upbeattechtw/Trina_Pi_UP201_MCU_Board/hardware/BOM/UP201 MCU BOARD 2V0 BOM.xlsx

UP201 MCU Board Revised: Tuesday, April 01, 2025
00_Placement Revision: 2.0
Bill Of Materials April 1,2025 16:55:33
Item | Component | Quantity | Reference | PCB Footprint | Description | Supplier [part#] | Manufacturer [part#] | comment
1 | 0.1uF, 25V, 20% | 53 | CB1,CB2,CB3,CB4,CB5,CB6,CB7,CB8,CB9,CB10,CB11,CB12,CB13,CB14,CB15,CB16,CB17,CB18,CB19,CB20,CB21,CB23,CB24,CB25,CB26,CB27,CB28,CB29,CB30,CB31,CB32,CB33,CB34,CB35,CB36,CB37,CB38,CB39,CB40,CB41,CB42,CB43,C46,C48,C50,C52,C54,C38,C39,C40,C41,C43,C55 | SMD0402 | CAP CER 0.1uF,25V,20%,SMD0402 | DigiKey | Yageo
2 | 0.01uF, 25V, 20% | 1 | CB22 | SMD0402 | CAP CER 0.01uF,25V,20%,SMD0402 | DigiKey | Yageo
3 | 2.2uF, 16V, 20% | 3 | C8,C14,CB44 | SMD0603 | CAP CER 2.2uF,16V,20%,SMD0603 | DigiKey | Yageo
4 | Connector_MCU_Board | 1 | CON1 | DIP40_51x21mm_2.54 | NC/Connector_MCU_Board | DigiKey |  | NC
5 | USBC 24P MIDDLE MOUNT | 1 | CON2 | USBC_24P_0_5P | USBC 24P MIDDLE MOUNT | DigiKey | Molex [2171840001]
6 | 10uF, 16V, 20% | 26 | CT1,C1,CT2,C2,CT3,C5,C6,C7,C9,C13,C15,C16,C17,C18,C19,C20,C22,C28,C31,C32,C45,C47,C49,C51,C53,C10 | SMD0603 | CAP CER 10uF,16V,20%,SMD0603 | DigiKey | Yageo
7 | 16pF, 50V, 20% | 2 | C3,C4 | SMD0402 | CAP CER 16pF,50V,20%,SMD0402 | DigiKey | Yageo
8 | 22uF, 10V, 20% | 2 | C11,C12 | SMD0603 | CAP CER 22uF,10V,20%,SMD0603 | DigiKey | Yageo
9 | 1uF, 16V, 20% | 3 | C21,C23,C26 | SMD0603 | CAP CER 1uF,16V,20%,SMD0603 | DigiKey | Yageo
10 | 1nF, 50V, 20% | 1 | C24 | SMD0402 | CAP CER 1nF,50V,20%,SMD0402 | DigiKey | Yageo
11 | 4.7uF, 16V, 20% | 2 | C25,C29 | SMD0603 | CAP CER 4.7uF,16V,20%,SMD0603 | DigiKey | Yageo
12 | 2.2uF, 25V, 10% | 1 | C27 | SMD0402 | CAP CER 2.2uF,25V,10%,SMD0402 | DigiKey | Yageo
13 | 220nF, 10V, 20% | 1 | C30 | SMD0402 | CAP CER 220nF,10V,20%,SMD0402 | DigiKey | Yageo
14 | 20pF, 50V, 10% | 2 | C33,C34 | SMD0402 | CAP CER 20pF,50V,10%,SMD0402 | DigiKey | Yageo
15 | 3.3uF, 16V, 20% | 1 | C35 | SMD0603 | CAP CER 3.3uF,16V,20%,SMD0603 | DigiKey | Yageo | 4.7uF substitute
16 | 330pF, 50V, 5% | 2 | C36,C37 | SMD0402 | CAP CER 330pF,50V,5%,SMD0402 | DigiKey | Yageo
18 | 1uF, 25V, 20% | 1 | C42 | SMD0603 | CAP CER 1uF,25V,20%,SMD0603 | DigiKey | Yageo
19 | 33nF, 16V, 20% | 1 | C44 | SMD0402 | CAP CER 33nF,16V,20%,SMD0402 | DigiKey | Yageo
20 | 22uF, 16V, 20% | 4 | C56,C57,C58,C59 | SMD0603 | CAP CER 22uF,16V,20%,SMD0603 | DigiKey | Yageo | 10uF substitute
21 | 47uF, 6.3V, 20% | 1 | C60 | SMD0603 | CAP CER 47uF,6.3V,20%,SMD0603 | DigiKey | Yageo | 22uF substitute
22 | Diode Zener 24V 150V clamp | 4 | D1,D2,D3,D4 | ESD_0603 | Diode Zener, Transient voltage suppressor 150V | Mouser | Littelfuse [PGB1010603]
23 | Diode Schottky 30V 5A | 1 | D5 | SOD128 | Diode Schottky,30V,5A,SOD128 | Mouser | Nexperia USA [PMEG3050BEP]
24 | 30Ω, 100MHz, 400mA | 5 | FB1,FB2,FB3,FB4,FB5 | SMD0603 | FERRITE BEAD 30Ω@100MHz,5A,SMD0603 | DigiKey | TDK [MPZ1608S300]
25 | LED RED | 2 | LED1,LED3 | SMD0603 | LED RED color | DigiKey | XINGLIGHT
26 | LED ORANGE | 1 | LED2 | SMD0603 | LED ORANGE color | DigiKey | XINGLIGHT
27 | 2.2uH, 2.19A, 59mΩ | 3 | L1,L2,L3 | SMD_4.5x3.9 | Inductor 2.2uH, 2.19A, 59mΩ | Mouser | TDK [VLCF4020T_2R2N]
28 | 1uH, shielded, 2.7A, 57mΩ | 1 | L4 | Metric2016 | Inductor 1uH, 2.7A, 57mΩ | Mouser | Murata [DFE201610E_1R0M=p2]
29 | Push Button Switch | 2 | PB1,PB2 | SW_SMD_2P_3x2.5 | Switch PushButton,Blue color,SMD_2P | DigiKey | Omron [B3U-1000P]
30 | 1KΩ, 1% | 7 | R1,R74,R75,R76,R82,R83,R88 | SMD0402 | RES 1KΩ,1/16W,1%,SMD0402 | DigiKey | Yageo | NC
31 | 4.7MΩ,1/16W,1% | 1 | R3 | SMD0402 | RES 4.7MΩ,1/16W,1%,SMD0402 | DigiKey | Yageo
32 | 10Ω,1% | 2 | R4,R21 | SMD0402 | RES 10Ω,1/16W,1%,SMD0402 | DigiKey | Yageo
33 | 1Ω,5% | 1 | R5 | SMD0402 | RES 1Ω,1/16W,5%,SMD0402 | DigiKey | Yageo
34 | 0Ω, 5% | 7 | R6,R7,R9,R10,R11,R17,R79 | SMD0402 | RES 0Ω,1/16W,5%,SMD0402 | DigiKey | Yageo
35 | 100KΩ, 1% | 10 | R8,R23,R26,R30,R31,R46,R47,R48,R49,R62 | SMD0402 | RES 100KΩ,1/16W,1%,SMD0402 | DigiKey | Yageo
36 | 0Ω, 100mW, 1% | 9 | R12,R13,R14,R16,R19,R20,R36,R52,R54 | SMD0603 | RES 0Ω,100mW,1%,SMD0603 | DigiKey | Yageo
37 | 51KΩ, 1% | 1 | R15 | SMD0402 | RES 51KΩ,1/16W,1%,SMD0402 | DigiKey | Yageo | NC
38 | 10KΩ, 1% | 16 | R22,R39,R41,R44,R45,R56,R58,R59,R66,R67,R68,R77,R78,R80,R81,R85 | SMD0402 | RES 10KΩ,1/16W,1%,SMD0402 | DigiKey | Yageo
39 | 1KΩ, 1% | 8 | R24,R27,R70,R71,R72,R73,R84,R87 | SMD0402 | RES 1KΩ,1/16W,1%,SMD0402 | DigiKey | Yageo
40 | 0Ω, 100mW, 1% | 2 | R25,R37 | SMD0603 | RES 0Ω,100mW,1%,SMD0603 | DigiKey | Yageo | NC
41 | 150KΩ,1% | 1 | R28 | SMD0402 | RES 150KΩ,1/16W,1%,SMD0402 | DigiKey | Yageo | NC
42 | 1.3KΩ,1% | 1 | R29 | SMD0402 | RES 1.3KΩ,1/16W,1%,SMD0402 | DigiKey | Yageo
43 | 4.7KΩ,1% | 5 | R32,R33,R34,R35,R53 | SMD0402 | RES 4.7KΩ,1/16W,1%,SMD0402 | DigiKey | Yageo
44 | 10KΩ,1% | 2 | R38,R42 | SMD0402 | RES 10KΩ,1/16W,1%,SMD0402 | DigiKey | Yageo | NC
45 | 22Ω,1% | 2 | R50,R86 | SMD0402 | RES 22Ω,1/16W,1%,SMD0402 | DigiKey | Yageo
46 | 22Ω,1% | 2 | R51,R55 | SMD0402 | RES 22Ω,1/16W,1%,SMD0402 | DigiKey | Yageo | NC
47 | 4.3KΩ,1% | 1 | R57 | SMD0402 | RES 4.3KΩ,1/16W,1%,SMD0402 | DigiKey | Yageo
48 | 12KΩ,1% | 1 | R60 | SMD0402 | RES 12KΩ,1/16W,1%,SMD0402 | DigiKey | Yageo
49 | 220Ω,1% | 1 | R61 | SMD0402 | RES 220Ω,1/16W,1%,SMD0402 | DigiKey | Yageo
50 | 20KΩ,1% | 1 | R63 | SMD0402 | RES 20KΩ,1/16W,1%,SMD0402 | DigiKey | Yageo
51 | 470Ω,1% | 1 | R64 | SMD0402 | RES 470Ω,1/16W,1%,SMD0402 | DigiKey | Yageo
52 | 15KΩ,1% | 1 | R65 | SMD0402 | RES 15KΩ,1/16W,1%,SMD0402 | DigiKey | Yageo
53 | 2.2KΩ,1% | 1 | R69 | SMD0402 | RES 2.2KΩ,1/16W,1%,SMD0402 | DigiKey | Yageo
54 | Circuit Break1 | 1 | SB1 | SJO_S | NC/Circuit Break1 |  |  | NC
55 | TestPoint,DIP_2.54 | 14 | TP3,TP4,TP5,TP6,TP7,TP8,TP9,TP10,TP11,TP12,TP13,TP14,TP15,TP16 | SIP_1P | NC/TP_2.54 |  |  | NC
56 | UP201 | 1 | U1 | WLCSP64_3x3_0.35 | IC UP201, Ultra low power SOC | Mouser (in progress) | Upbeat Tech
57 | MX25U1632 | 1 | U2 | USON8_2x3_0.5 | IC MX25U1632FZU, NOR Flash,16Mb | DigiKey | Macronix | MX25U16356 upper limit
58 | BQ21040DBVR | 1 | U3 | SOT23-6 | IC BQ21040DBVR, power management, charger | DigiKey | Texas Instrument | NC
59 | TPS65023 | 1 | U4 | WQFN40_5x5_0.4 | IC TPS65023, power management with i2c | DigiKey | Texas Instrument
60 | TPS628604 | 1 | U5 | DSBGA8_1.3x0.6_0.35 | IC TPS628604, Regulator, 600mA output | DigiKey | Texas Instrument
61 | SN74LVC2G14DBVR | 1 | U6 | SOT23-6 | IC SN74LVC1G14DBVR_SOT23, Dual Schmitt trigger | Mouser | Texas Instrument
62 | FT2232HP | 1 | U8 | QFN68_8x8_0.4 | IC FT2232HP, USB bridge Type-C 3.0 | Mouser | FTDI
63 | CommonModeChoke 23nH 500mA | 1 | U9 | 0805_4p | Common Mode Choke, 23nH @ 100MHz, 500mA | DigiKey | Coilcraft
64 | 93LC66BT_I/OT | 1 | U10 | SOT23-6 | IC 93LC66BT_I/OT, EEPROM 256x16 | Mouser | Microchip
65 | TXS0104ERUT | 2 | U11,U12 | UQFN12_1.7x2_0.4 | IC TXS0104ERUT, Bi-dir level shifter | Mouser | Texas Instrument
66 | SN74LVC1G08DBVR | 1 | U13 | SOT23-5 | IC SN74LVC1G08DBVR_SOT23, AND gate | Mouser | Texas Instrument
67 | TPS22917 | 1 | U14 | SOT23-6 | IC TPS22917, P-ch Power Switch, 5.5V,2A | Mouser | Texas Instrument | NC
68 | TPS22917 | 1 | U15 | SOT23-6 | IC TPS22917, P-ch Power Switch, 5.5V,2A | Mouser | Texas Instrument | NC
69 | TPS22917 | 1 | U16 | SOT23-6 | IC TPS22917, P-ch Power Switch, 5.5V,2A | Mouser | Texas Instrument
70 | Crystal_32.768KHz_12.5p_70K | 1 | Y1 | Crystal_3.2x1.5_SMD | Crystal 32.768KHz,20ppm,12.5p_70KΩ_SMD | Mouser | ECS [ECS-.327-12.5-34B]
71 | Crystal_12MHz,50PPM | 1 | Y2 | XTAL_4P_2.5X2 | Crystal 12MHz,50ppm,2_0.5x2mm | DigiKey [XC2722] | ECS [ECS-120-10-36Q]
