upbeattechtw/Trina_Pi_UP201_MCU_Board/hardware/BOM/UP201 MCU BOARD 2V0 position.xlsx

PartType | RefDes | PartDecal | Pins | Layer | Orient. | X | Y | SMD | Glued
C0603 | C1 | C0603 | 2 | Bottom | 90 | 997.736 | 913.287 | Yes | No
C0603 | C2 | C0603 | 2 | Top | 0 | 1003.986 | 775.787 | Yes | No
C0402 | C3 | C0402 | 2 | Top | 90 | 931.25 | 1187.5 | Yes | No
C0402 | C4 | C0402 | 2 | Top | 90 | 993.75 | 1187.5 | Yes | No
C0603 | C5 | C0603 | 2 | Top | 270 | 878.986 | 69.537 | Yes | No
C0603 | C6 | C0603 | 2 | Top | 0 | 810.236 | 625.787 | Yes | No
C0603 | C7 | C0603 | 2 | Top | 180 | 853.986 | 557.037 | Yes | No
C0603 | C8 | C0603 | 2 | Bottom | 90 | 547.736 | 538.287 | Yes | No
C0603 | C9 | C0603 | 2 | Top | 180 | 566.486 | 563.287 | Yes | No
C0603 | C10 | C0603 | 2 | Top | 270 | 941.486 | 69.537 | Yes | No
C0603 | C11 | C0603 | 2 | Top | 180 | 466.486 | 50.787 | Yes | No
C0603 | C12 | C0603 | 2 | Top | 180 | 966.486 | 619.537 | Yes | No
C0603 | C13 | C0603 | 2 | Top | 180 | 641.486 | 769.537 | Yes | No
C0603 | C14 | C0603 | 2 | Bottom | 0 | 460.236 | 507.037 | Yes | No
C0603 | C15 | C0603 | 2 | Bottom | 180 | 460.236 | 563.287 | Yes | No
C0603 | C16 | C0603 | 2 | Top | 0 | 572.736 | 688.287 | Yes | No
C0603 | C17 | C0603 | 2 | Bottom | 0 | 647.736 | 157.037 | Yes | No
C0603 | C18 | C0603 | 2 | Bottom | 180 | 778.986 | 307.037 | Yes | No
C0603 | C19 | C0603 | 2 | Bottom | 90 | 647.736 | 269.537 | Yes | No
C0603 | C20 | C0603 | 2 | Bottom | 90 | 810.236 | 400.787 | Yes | No
C0603 | C21 | C0603 | 2 | Bottom | 180 | 266.486 | 1119.537 | Yes | No
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
SJO_S | SB1 | SJO_S | 2 | Top | 180 | 500 | 985 | Yes | No
SIP_1P | TP3 | SIP_1P | 1 | Top | 90 | 272.736 | 63.287 | Yes | No
SIP_1P | TP4 | SIP_1P | 1 | Top | 90 | 360.236 | 63.287 | Yes | No
SIP_1P | TP5 | SIP_1P | 1 | Top | 0 | 1128.986 | 2319.537 | Yes | No
SIP_1P | TP6 | SIP_1P | 1 | Bottom | 0 | 178.986 | 57.037 | Yes | No
SIP_1P | TP7 | SIP_1P | 1 | Top | 0 | 1153.986 | 69.537 | Yes | No
SIP_1P | TP8 | SIP_1P | 1 | Bottom | 0 | 1153.986 | 69.537 | Yes | No
SIP_1P | TP9 | SIP_1P | 1 | Bottom | 0 | 353.986 | 1919.537 | Yes | No
SIP_1P | TP10 | SIP_1P | 1 | Top | 0 | 853.986 | 1869.537 | Yes | No
SIP_1P | TP11 | SIP_1P | 1 | Bottom | 0 | 1128.986 | 2319.537 | Yes | No
SIP_1P | TP12 | SIP_1P | 1 | Top | 0 | 178.986 | 57.037 | Yes | No
SIP_1P | TP13 | SIP_1P | 1 | Top | 0 | 197.736 | 675.787 | Yes | No
SIP_1P | TP14 | SIP_1P | 1 | Top | 0 | 278.986 | 675.787 | Yes | No
SIP_1P | TP15 | SIP_1P | 1 | Top | 0 | 366.486 | 675.787 | Yes | No
SIP_1P | TP16 | SIP_1P | 1 | Top | 90 | 460.236 | 675.787 | Yes | No
WLCSP64_3X3_0.35 | U1 | WLCSP64_3X3_0.35 | 64 | Top | 270 | 828.986 | 844.537 | Yes | No
USON8_2X3_0.5 | U2 | USON8_2X3_0.5 | 9 | Top | 0 | 706.486 | 1145.787 | Yes | No
SOT23-6 | U3 | SOT23-6 | 6 | Top | 0 | 341.486 | 1113.287 | Yes | No
WQFN40_5X5_0.4 | U4 | WQFN40_5X5_0.4 | 53 | Top | 180 | 647.736 | 344.537 | No | No
DSBGA8_1.3X0.6_0.35 | U5 | DSBGA8_1.3X0.6_0.35 | 8 | Top | 270 | 316.486 | 363.287 | Yes | No
SOT23-6 | U6 | SOT23-6 | 6 | Top | 180 | 360.236 | 907.037 | Yes | No
QFN68_8X8_0.4 | U8 | QFN68_8X8_0.4 | 69 | Bottom | 0 | 641.486 | 1569.537 | Yes | No
0805_4P | U9 | 0805_4P | 4 | Bottom | 270 | 617.986 | 1869.537 | Yes | No
SOT_23_6 | U10 | SOT_23_6 | 6 | Top | 0 | 960.236 | 1725.787 | Yes | No
UQFN12_1.7X2_0.4 | U11 | UQFN12_1.7X2_0.4 | 12 | Bottom | 180 | 372.736 | 1513.287 | Yes | No
UQFN12_1.7X2_0.4 | U12 | UQFN12_1.7X2_0.4 | 12 | Bottom | 0 | 960.236 | 1582.037 | Yes | No
SOT23-5 | U13 | SOT23-5 | 5 | Top | 90 | 516.486 | 894.537 | Yes | No
SOT23-6 | U14 | SOT23-6 | 6 | Top | 0 | 241.486 | 1282.037 | Yes | No
SOT23-6 | U15 | SOT23-6 | 6 | Top | 0 | 241.486 | 1519.537 | Yes | No
SOT23-6 | U16 | SOT23-6 | 6 | Top | 270 | 893.75 | 1343.75 | Yes | No
CRYSTAL_3.2X1.5_SMD | Y1 | CRYSTAL_3.2X1.5_SMD | 2 | Top | 0 | 962.5 | 1087.5 | Yes | No
XTAL_4P_2.5X2 | Y2 | XTAL_4P_2.5X2 | 4 | Bottom | 0 | 628.986 | 1313.287 | Yes | No
