upbeattechtw/Trina_Pi_UP201_MCU_Board/hardware/PDF/UP201 MCU BOARD 2V0-schematics.pdf

# Version Description

# 0.1 1. Initial

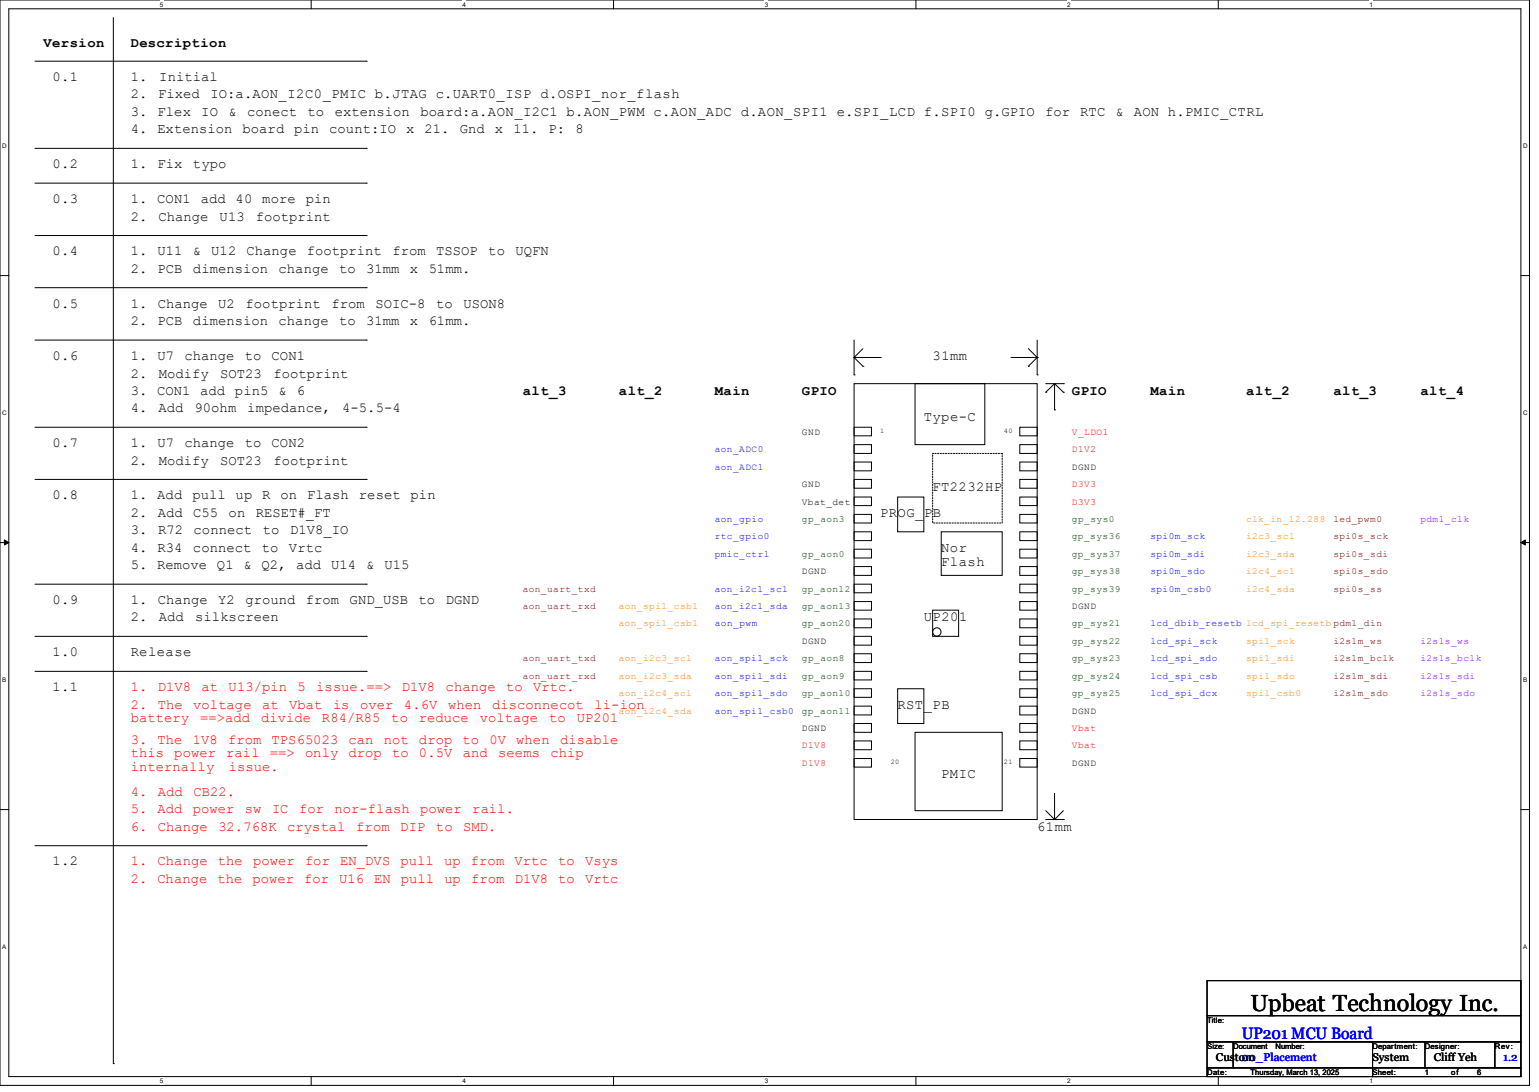
[picture p1: page 1]

2. Fixed IO: a.AON_I2C0_PMIC b.JTAG c.UART0_ISP d.OSPI_nor_flash
3. Flex IO & conect to extension board:a.AON_I2C1 b.AON_PWM c.AON_ADC d.AON_SPI1 e.SPI_LCD f.SPI0 g.GPIO for RTC & AON
4. Extension board pin count:IO x 21. Gnd x 11. P: 8

0.4 1. U11 & U12 Change footprint from TSSOP to UQFN

2. PCB dimension change to 31mm x 51mm.

0.5 1. Change U2 footprint from SOIC-8 to USON8

2. PCB dimension change to 31mm x 61mm.

0.8 1. Add pull up R on Flash reset pin

0.9 1. Change Y2 ground from GND_USB to DGND

1.1 1. D1V8 at U13/pin 5 issue.==> D1V8 change to Vrtc.

2. The voltage at Vbat is over 4.6V when disconnecot li-ion
battery ==>add divide R84/R85 to reduce voltage to UP201
3. The 1V8 from TPS65023 can not drop to 0V when disable
this power rail ==> only drop to 0.5V and seems chip
internally issue.
4. Add CB22.
5. Add power sw IC for nor-flash power rail.
6. Change 32.768K crystal from DIP to SMD.

1.2 1. Change the power for EN_DVS pull up from Vrtc to Vsys

2. Change the power for U16 EN pull up from D1V8 to Vrtc

D5V

BQ21040

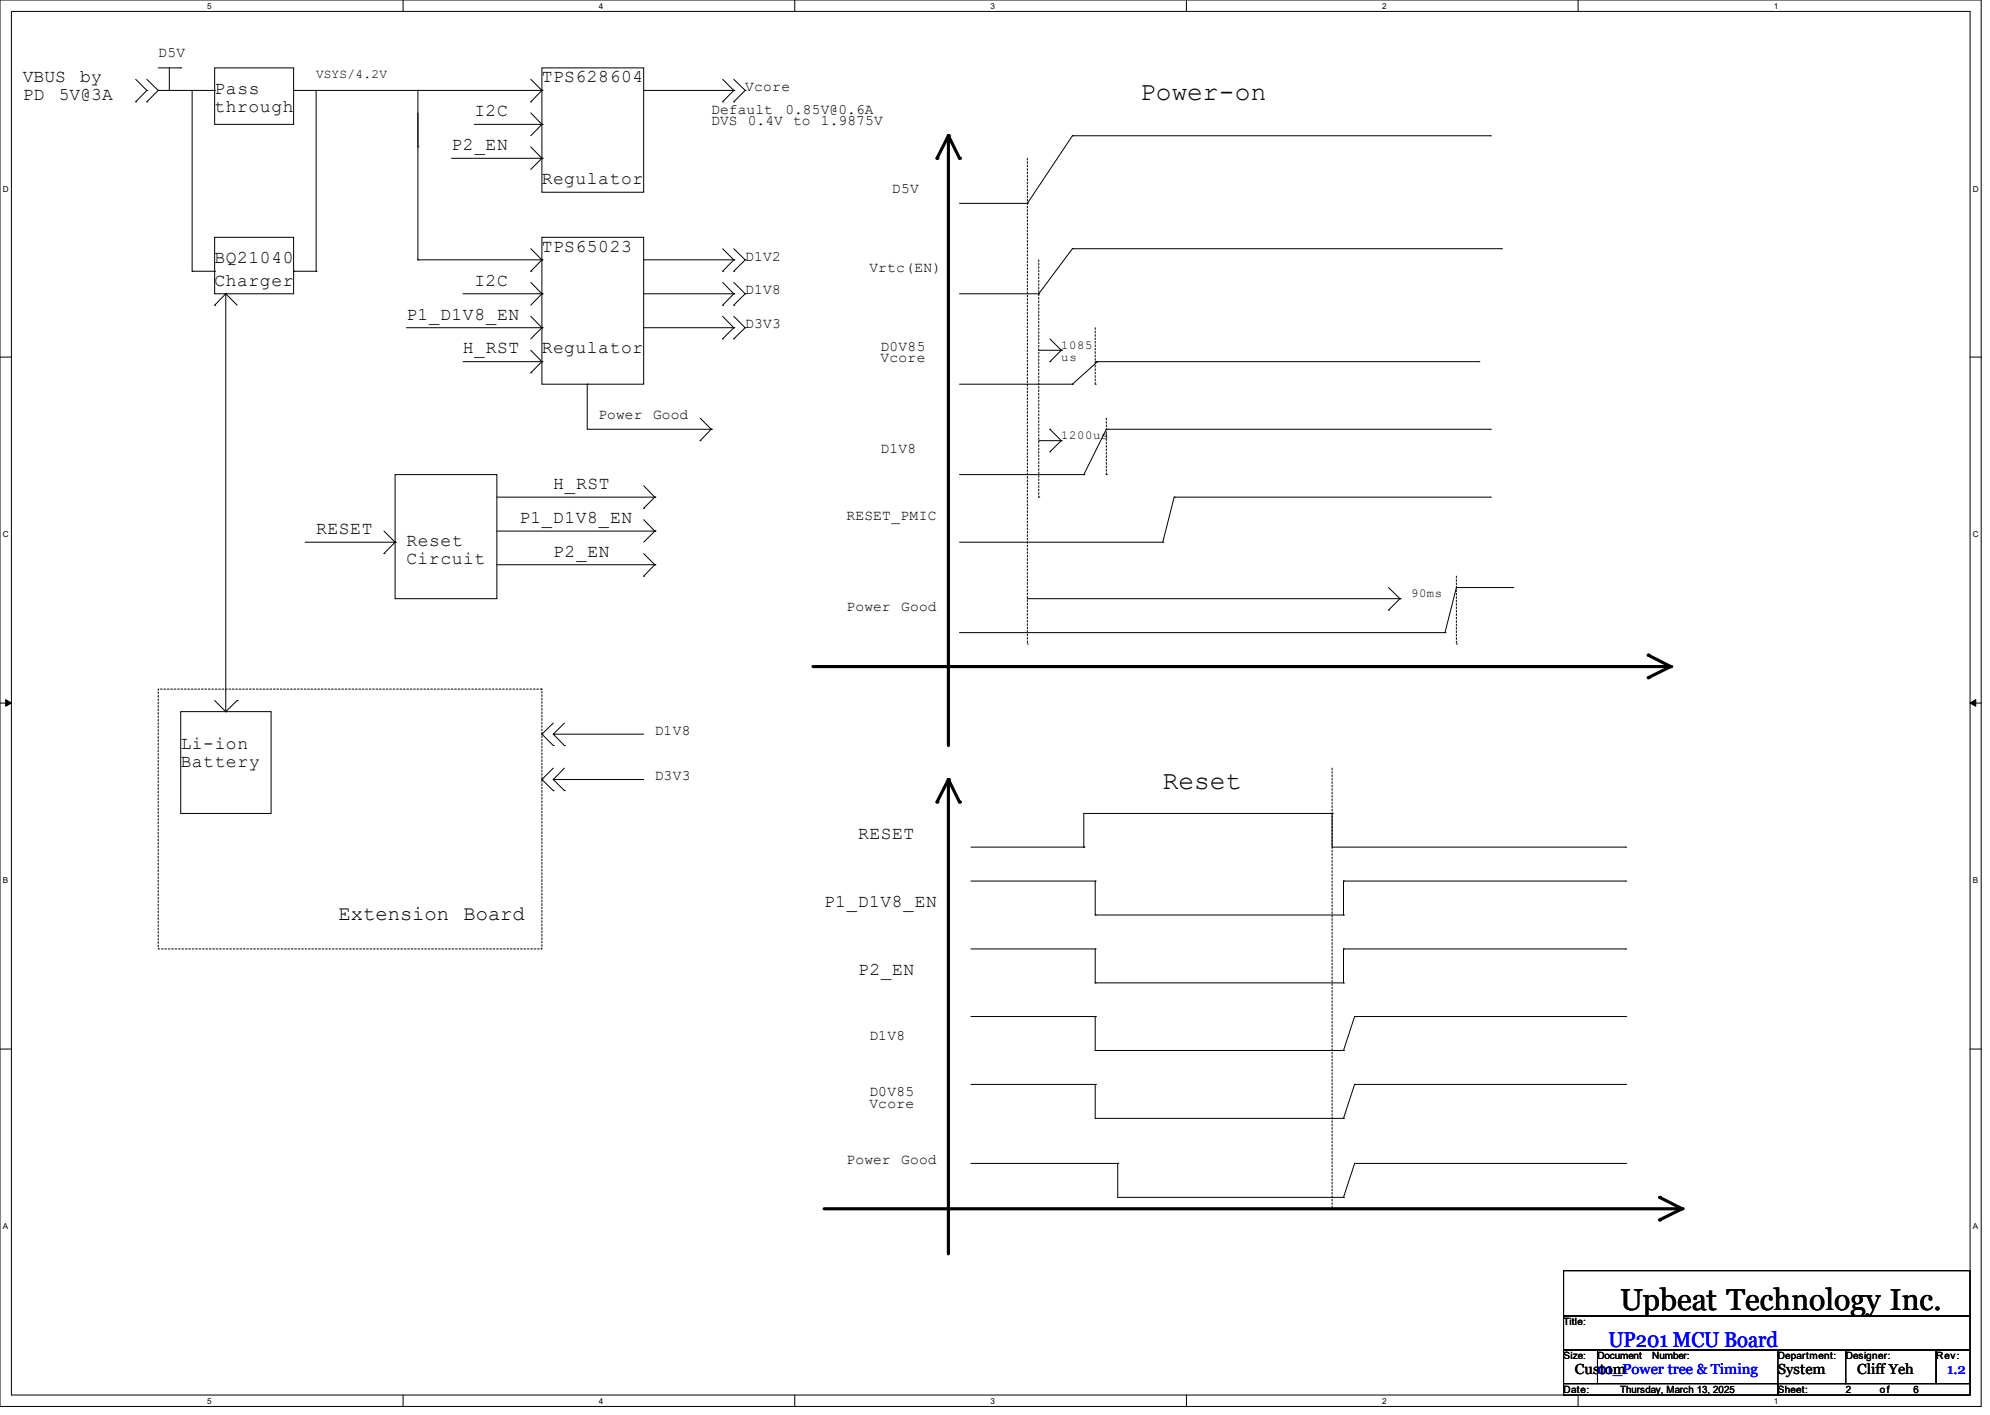
[picture p2: page 2]
VBUS by; VSYS/4.2V; TPS628604; Vcore Default 0.85V@0.6A; DVS 0.4V to 1.9875V I2C; Charger; Regulator; TPS65023; Power Good; Extension Board; Li-ion Battery; Reset Circuit; RESET; Pass through; RESET_PMIC; Vcore; Vrtc(EN); H_RST; Power-on; Reset; D0V85 Vcore; Department:; Designer: 01_Power tree & Timing; Thursday, March 13, 2025; 6 System; Cliff Yeh

Upbeat Technology Inc.

UP201 MCU Board Custom

# OSPI_SD3 OSPI_SD2 OSPI_SD1 OSPI_SD0 OSPI_CSB1 OSPI_CSB0 OSPI_SCLK RSTN GND

# SPI0_SDI SPI0_CSB0 OSPI_CSB1 AON_ADC0 AON_ADC1 AON_SPI1_SDO

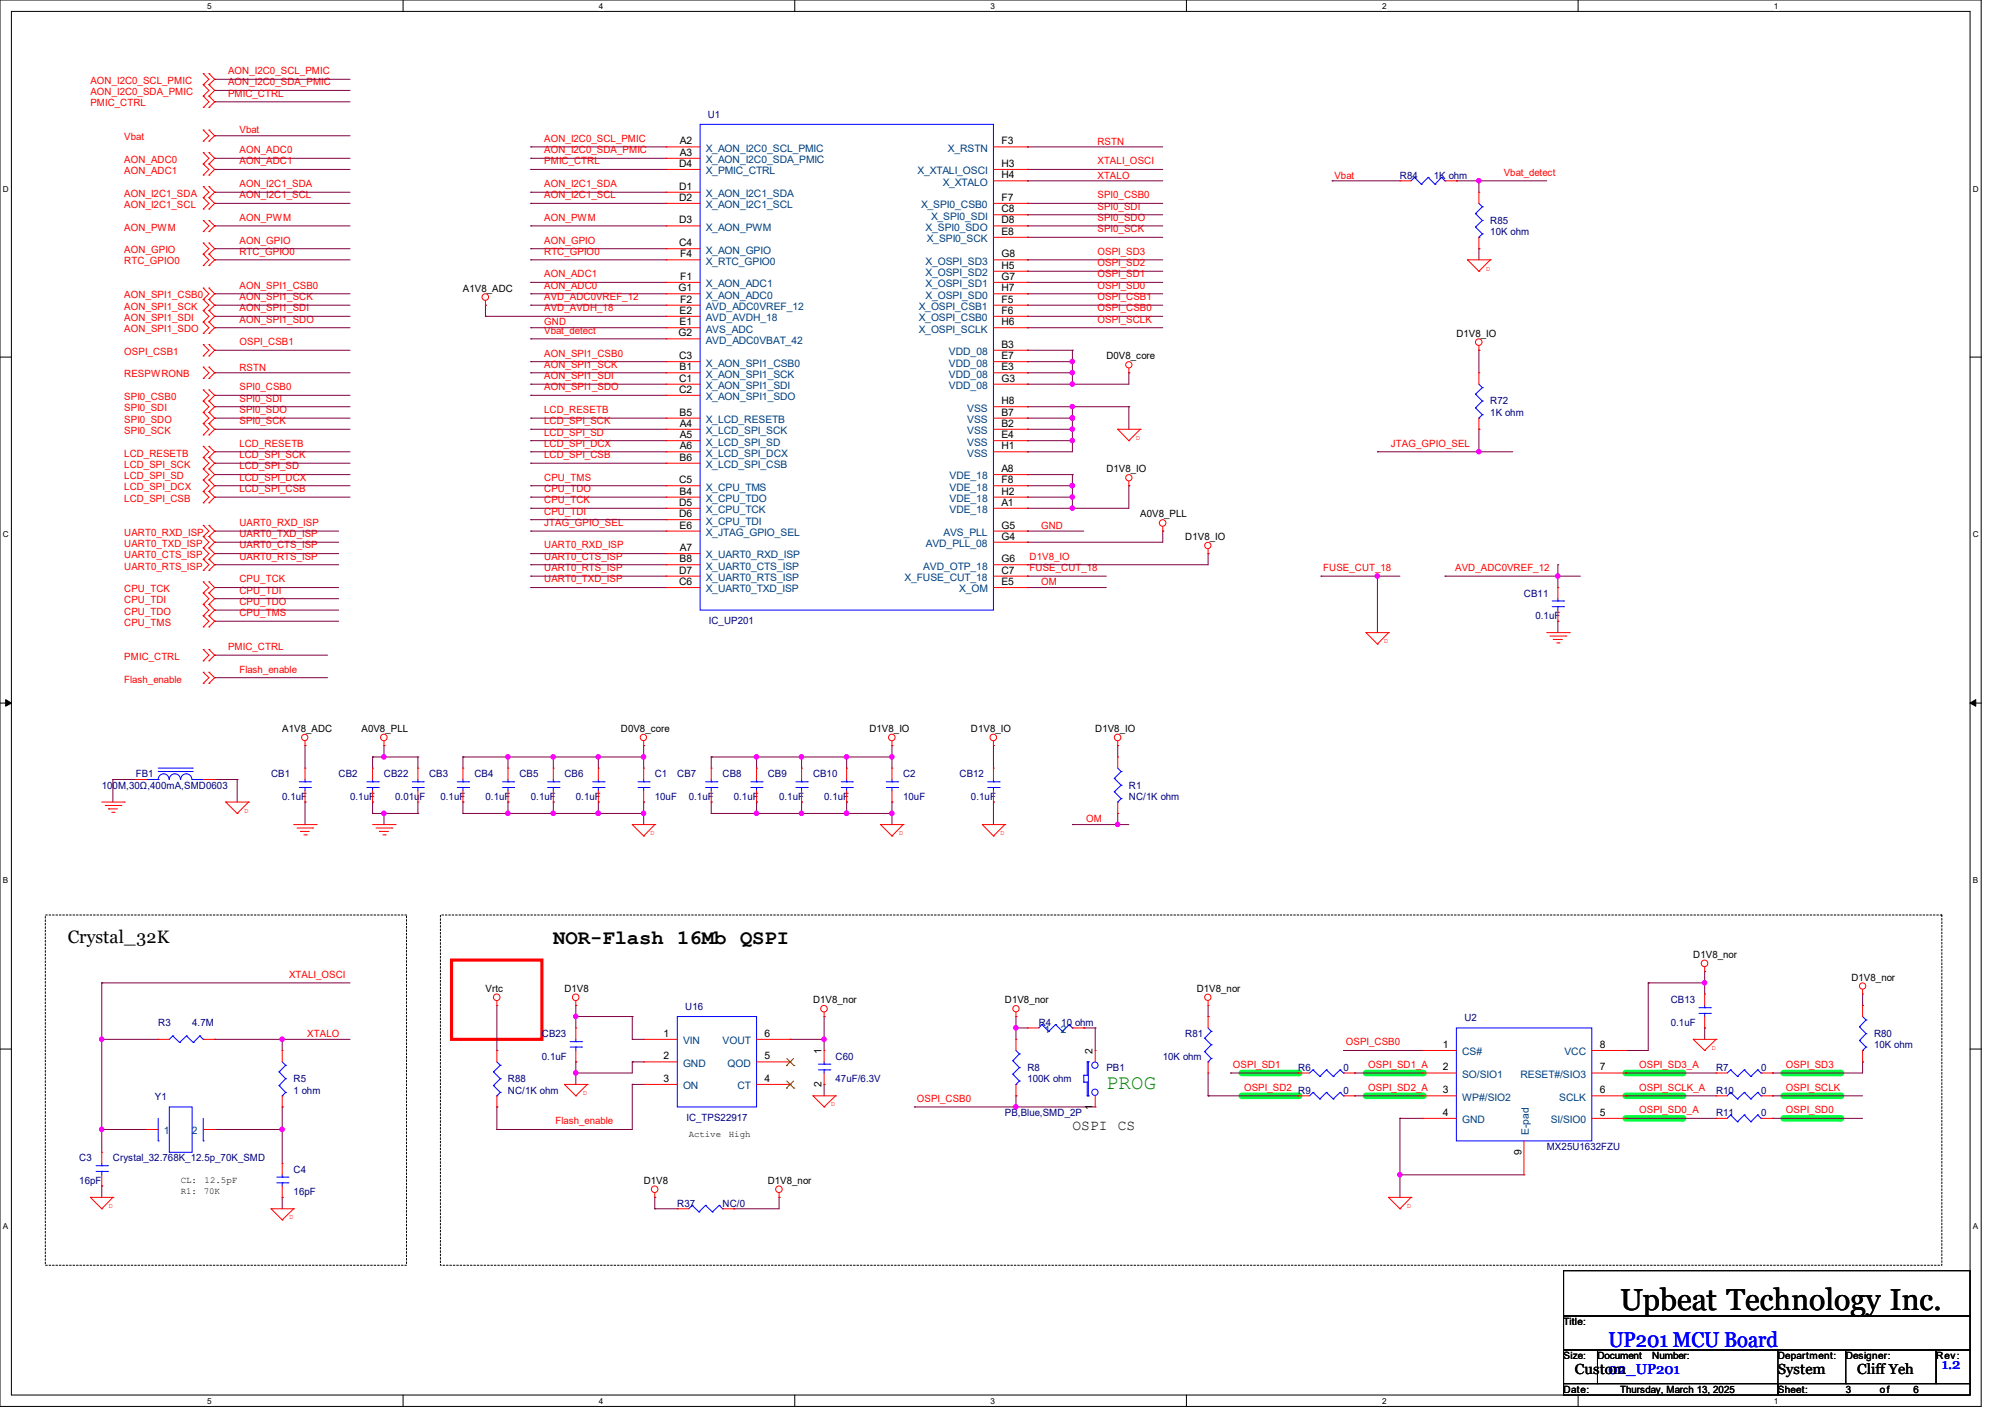
[picture p3: page 3]

# LDO1&2

# D1V8_IO

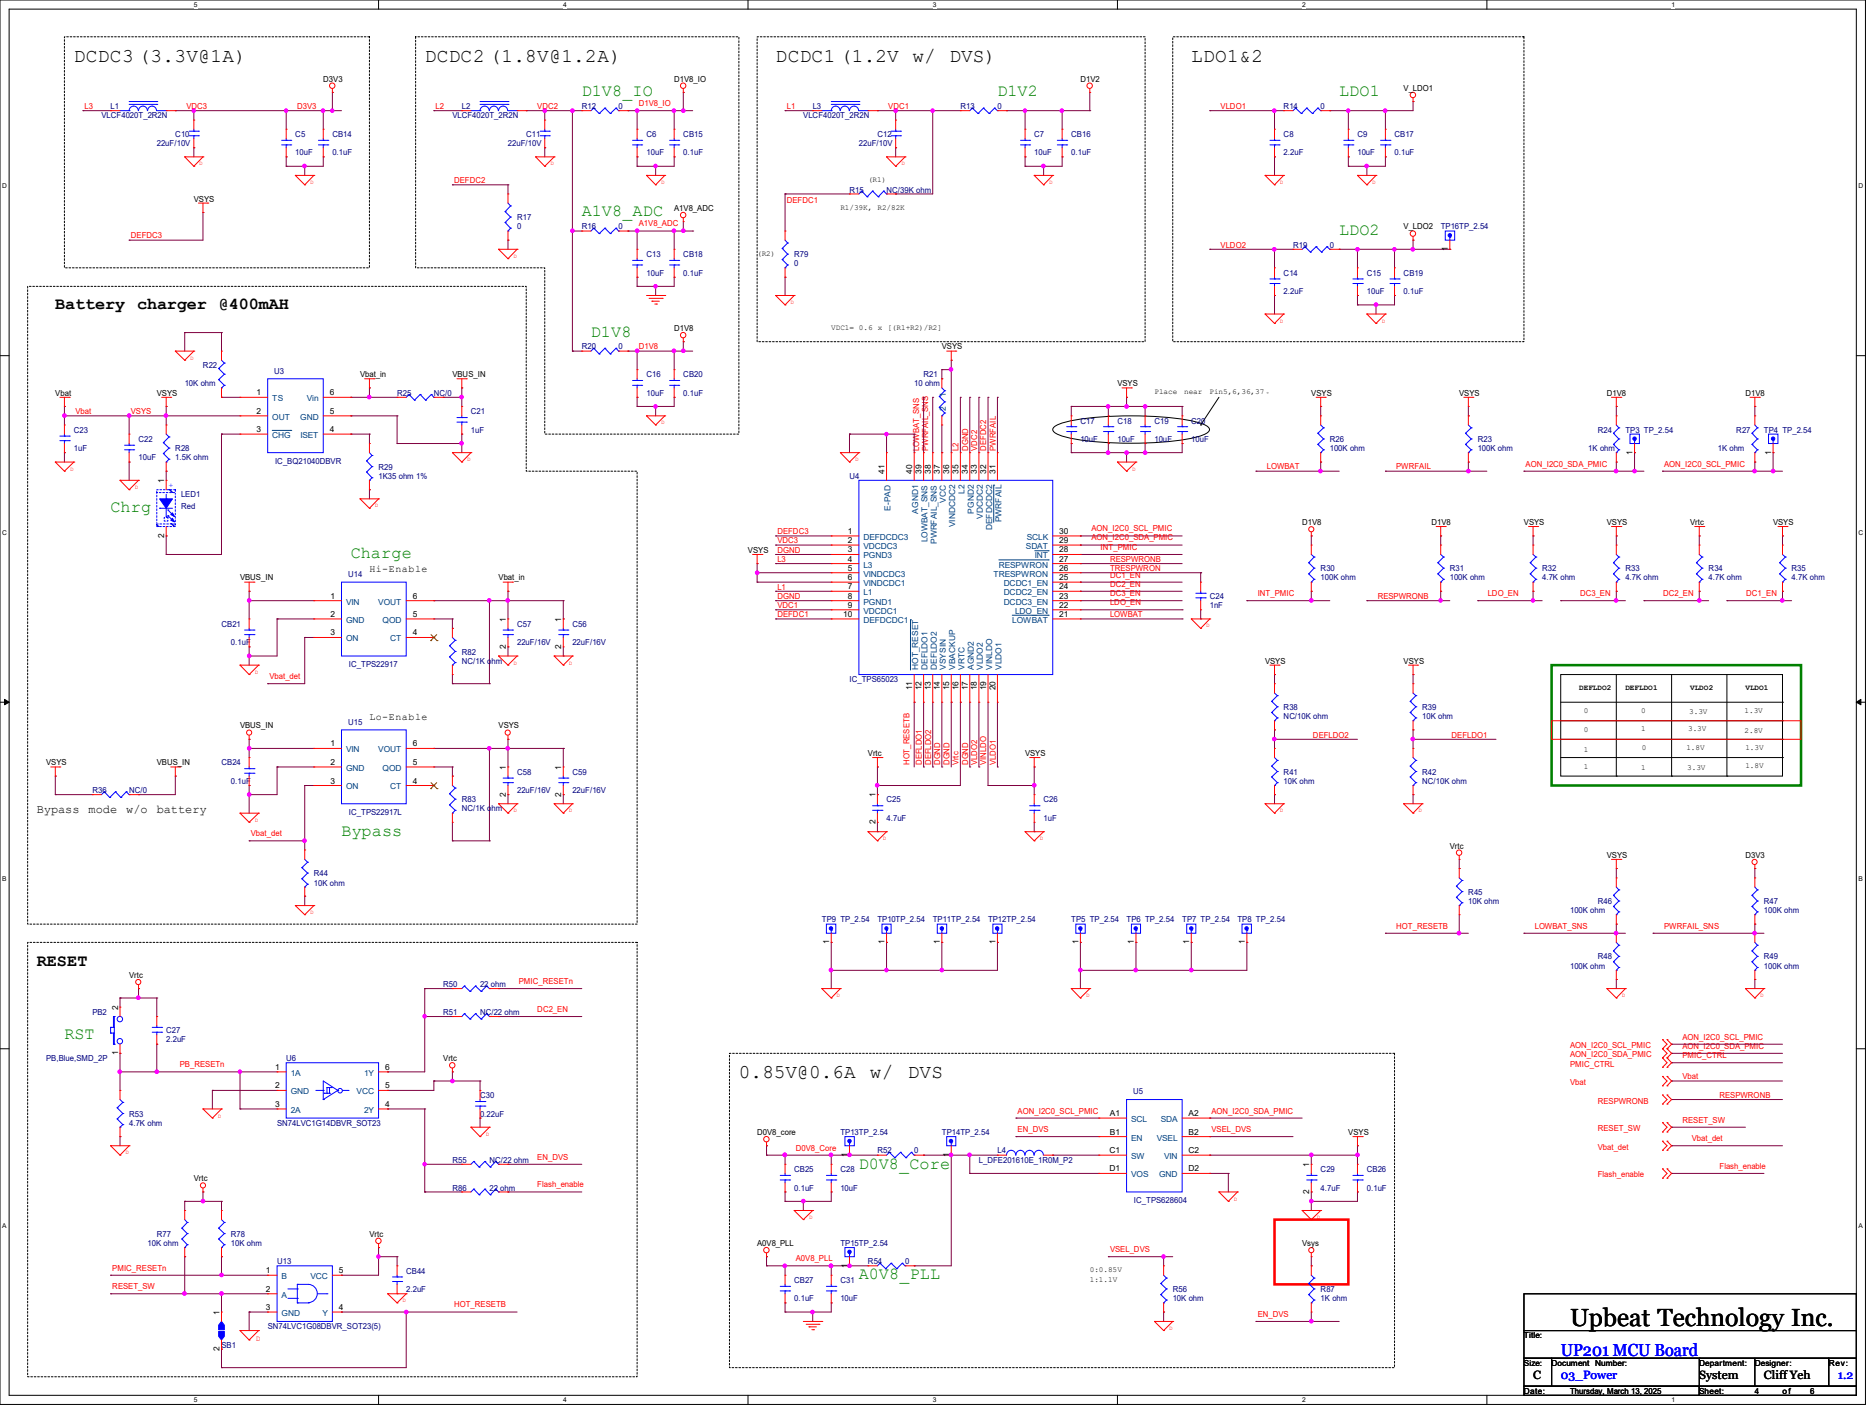
[picture p4: page 4]

# Differential impedance 90ohm, W:S:W=4:5.5:4

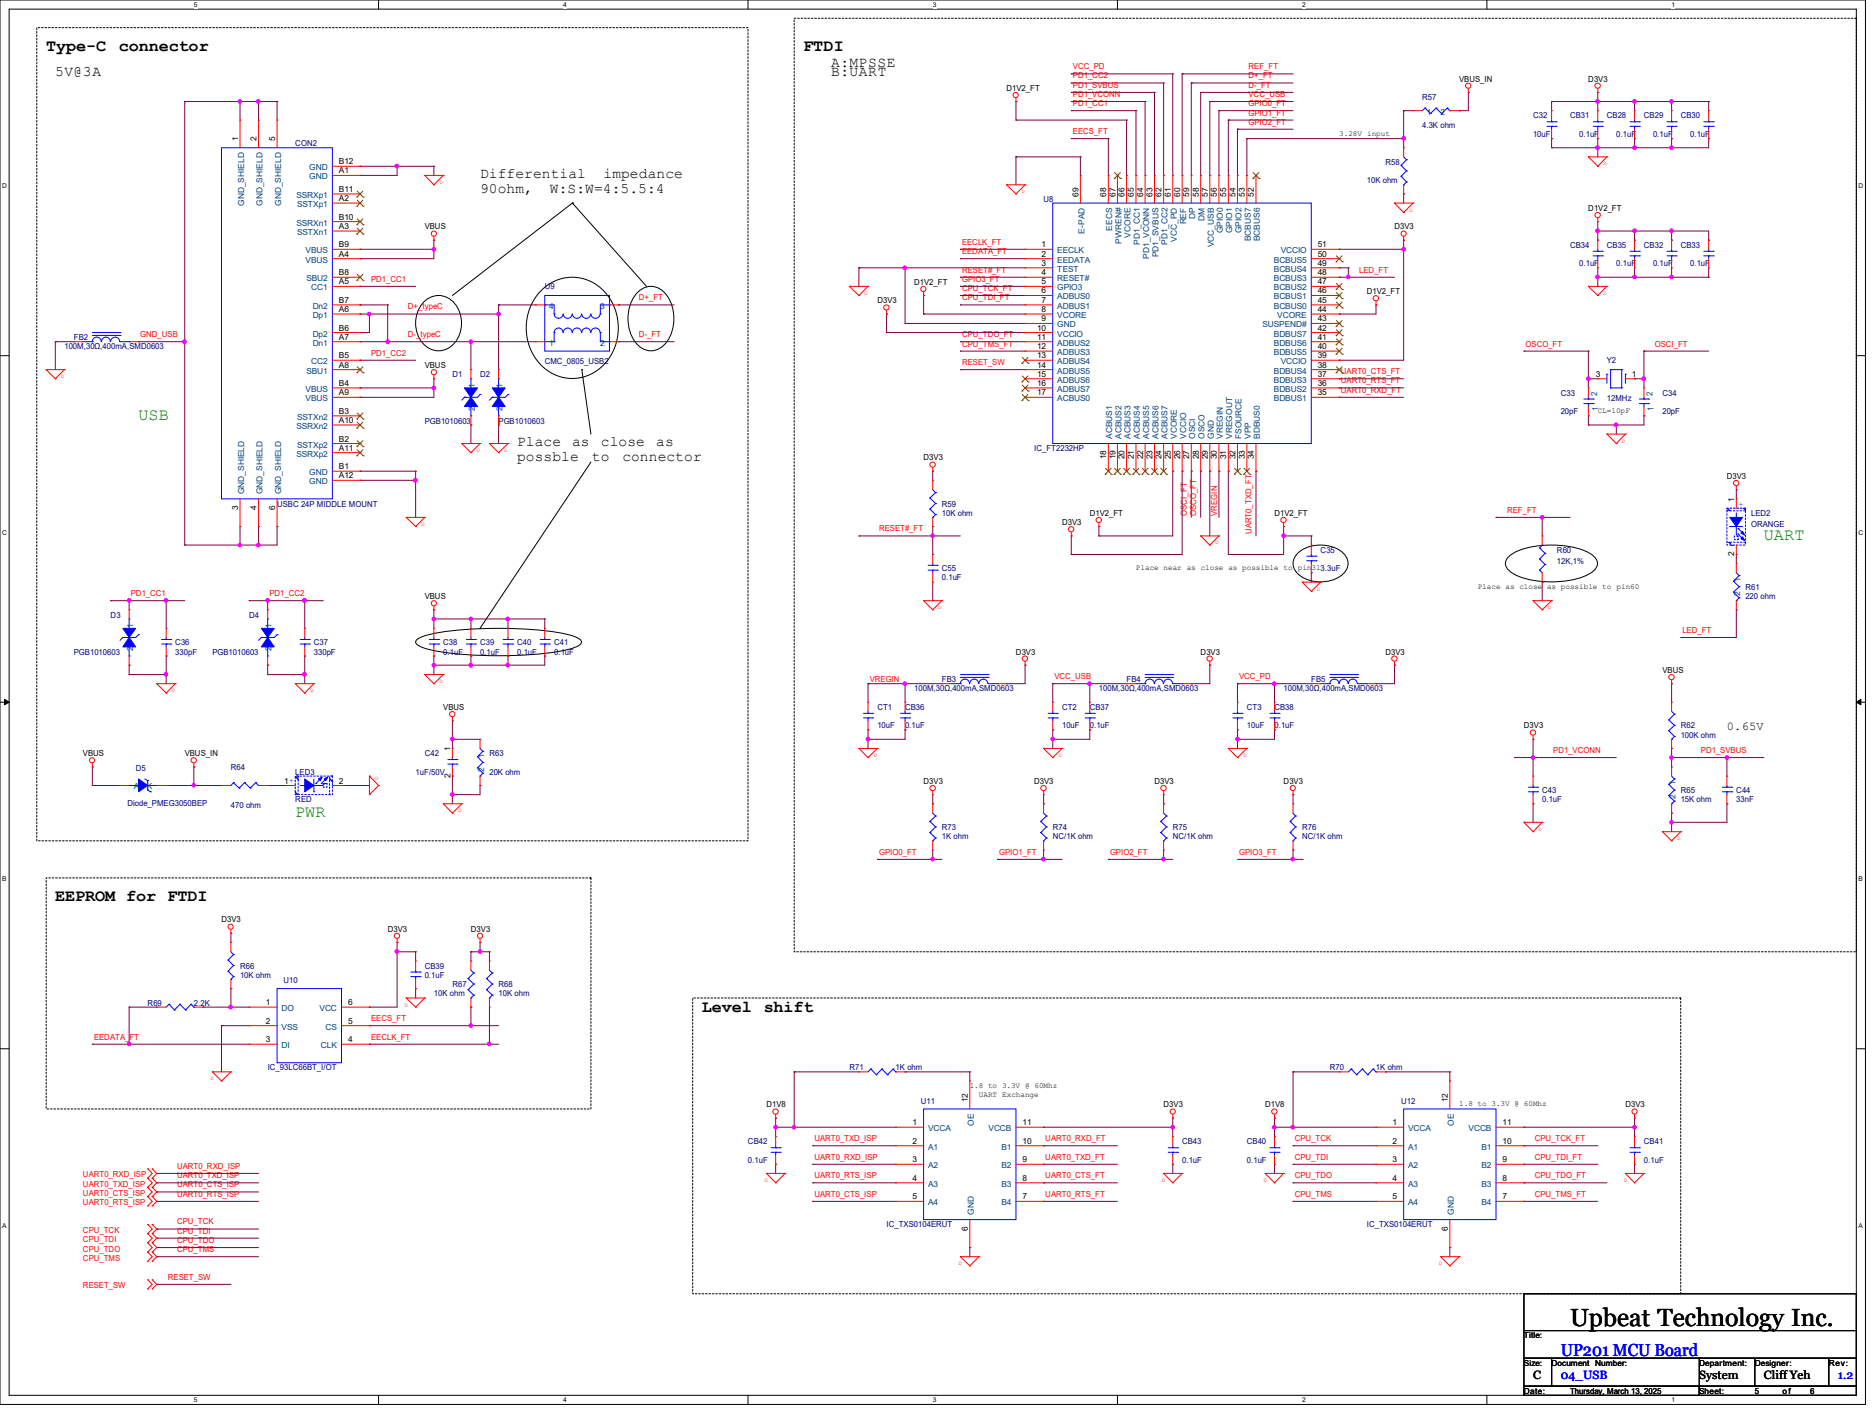
[picture p5: page 5]

Place as close as
possble to connector

Place near as close as possible to pin31

### Signal & power pad

1 | 41 | Ground pad

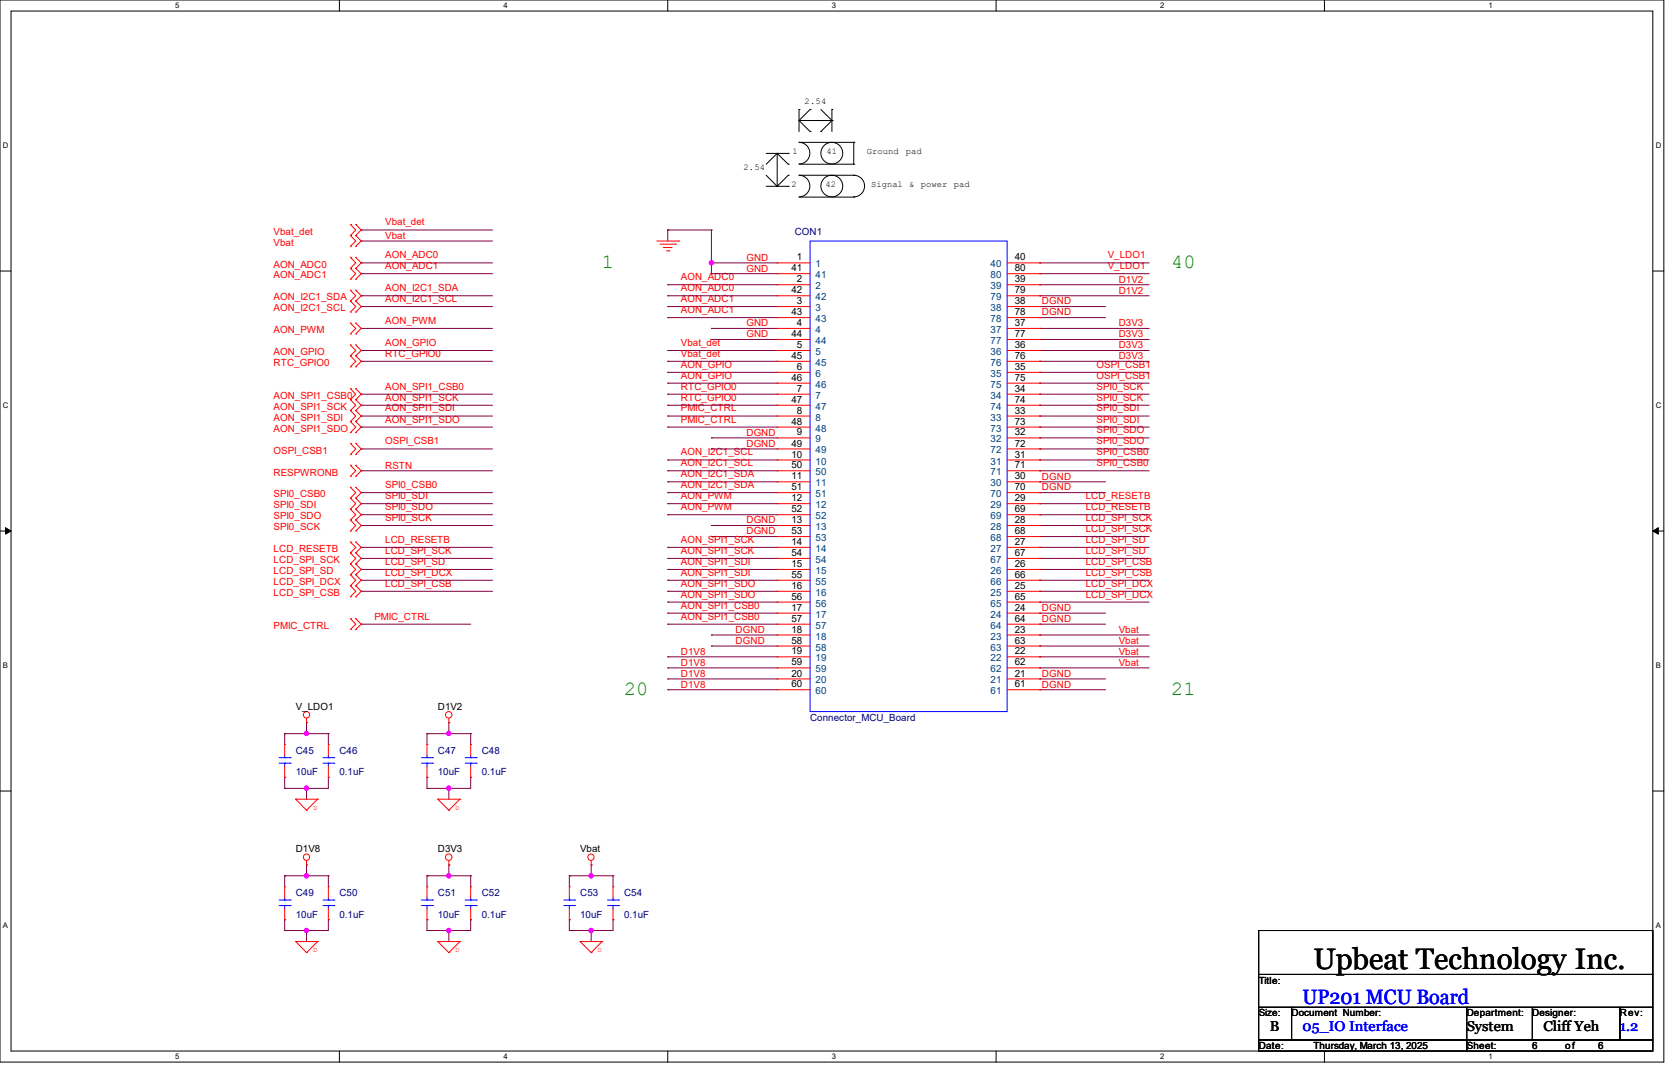
[picture p6: page 6]

Vbat Vbat Vbat DGND
