upbeattechtw/Trina_Pi_UP201_MCU_Board/hardware/PDF/UP201 MCU BOARD 2V0-Assembly_BOTTOM.pdf

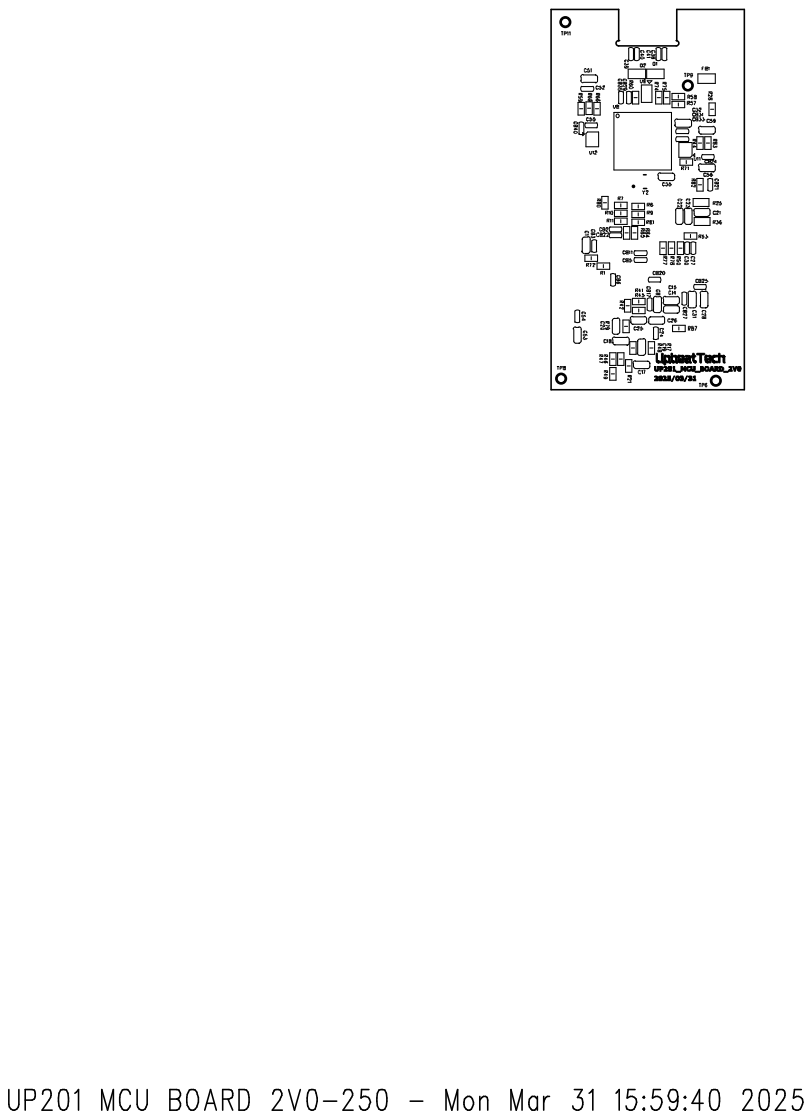
[picture p7: page 1]
