upbeattechtw/Trina_Pi_UP201_MCU_Board/hardware/PDF/UP201 MCU BOARD 2V0-Assembly_TOP.pdf

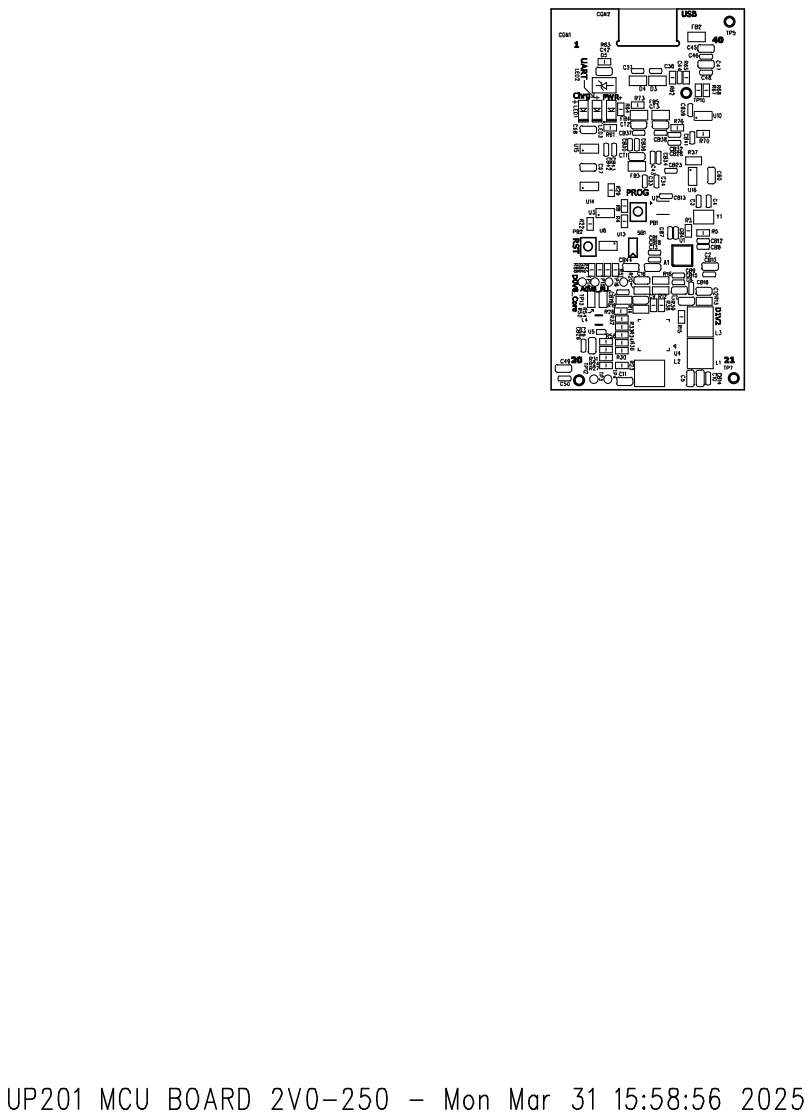
[picture p8: page 1]
