upbeattechtw/Trina_Pi_UP201_MCU_Board/hardware/PDF/UP201 MCU BOARD 2V0-Gerber_complete.pdf

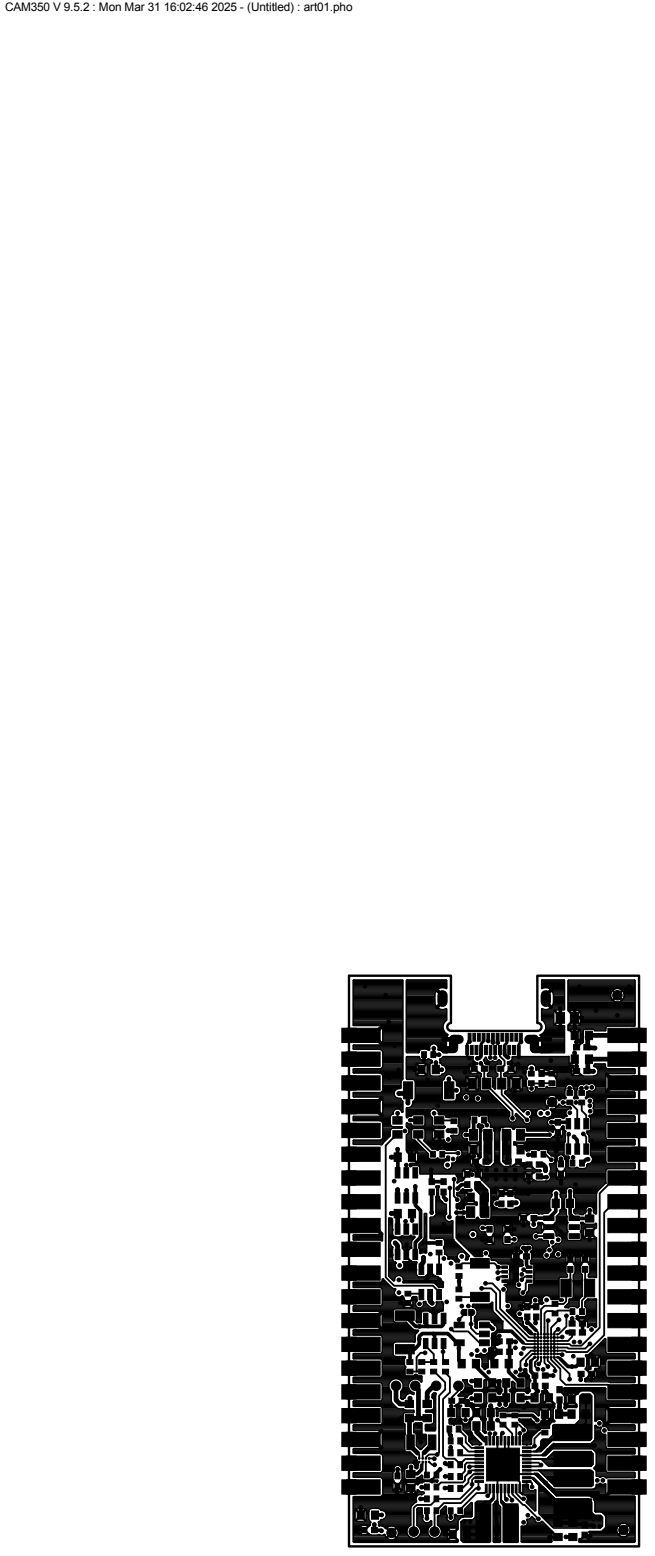
[picture p9: page 1]

CAM350 V 9.5.2 : Mon Mar 31 16:02:46 2025 - (Untitled) : art01.pho

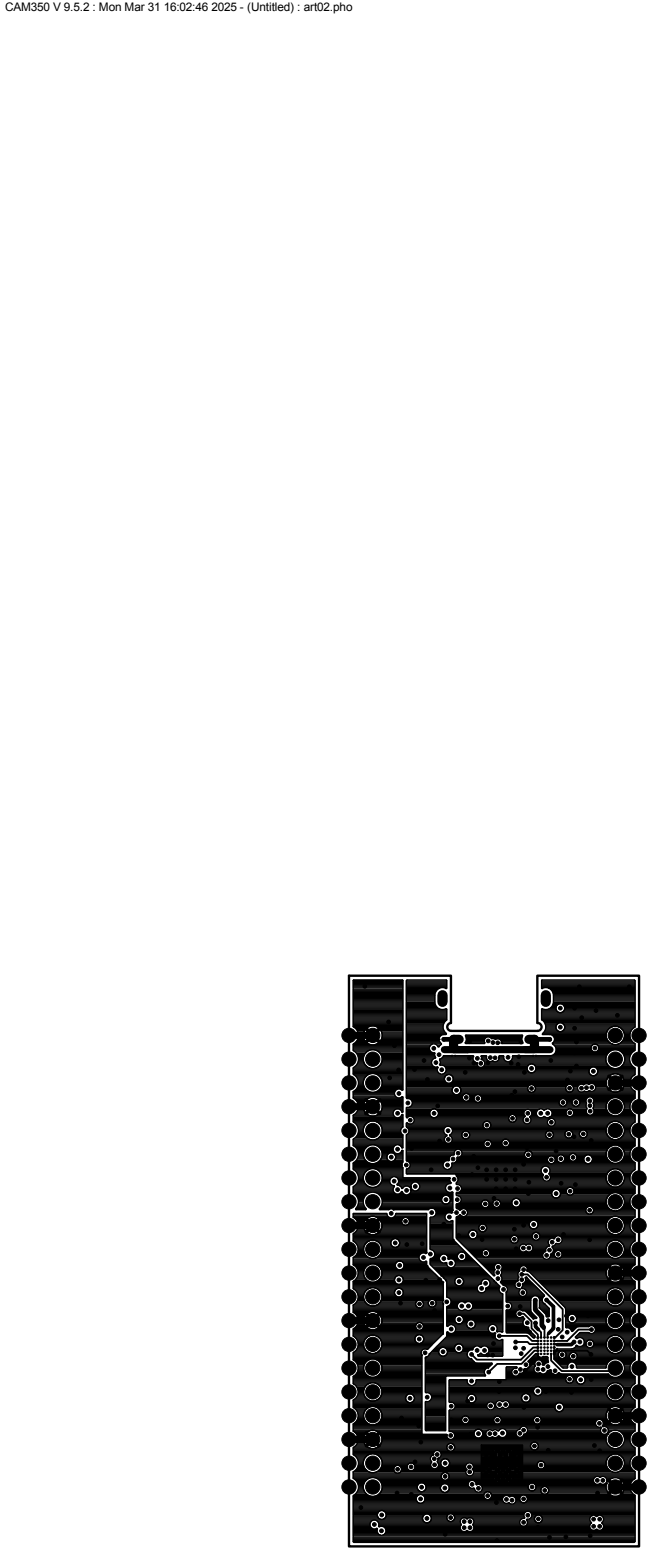
[picture p10: page 2]

CAM350 V 9.5.2 : Mon Mar 31 16:02:46 2025 - (Untitled) : art02.pho

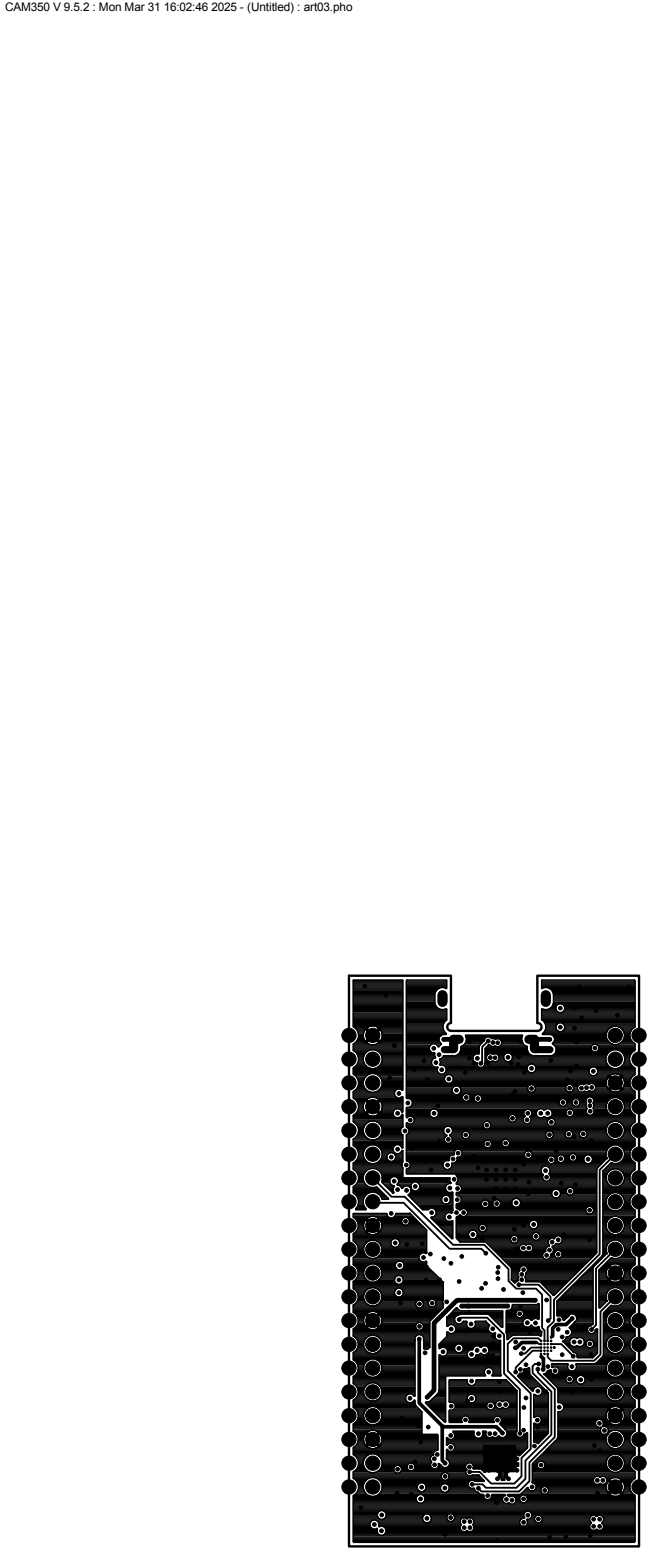
[picture p11: page 3]

CAM350 V 9.5.2 : Mon Mar 31 16:02:46 2025 - (Untitled) : art03.pho

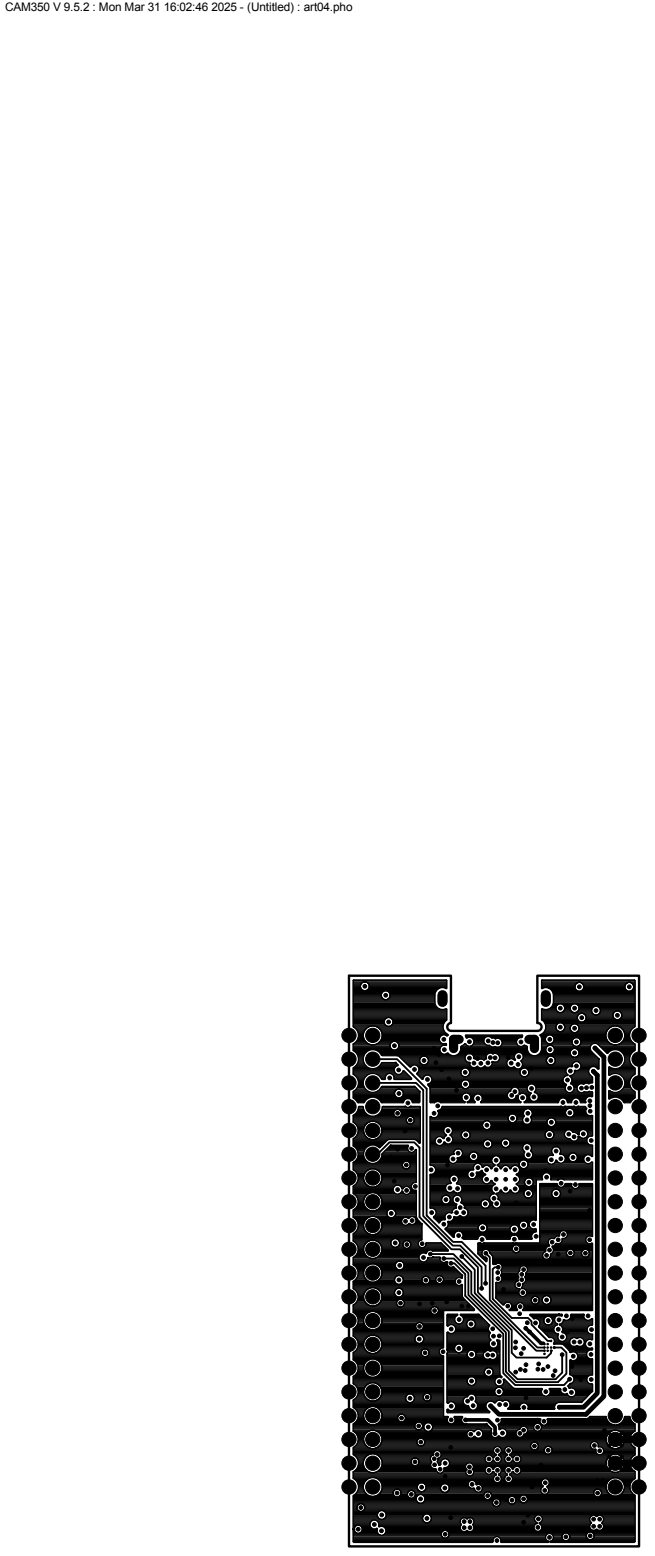
[picture p12: page 4]

CAM350 V 9.5.2 : Mon Mar 31 16:02:46 2025 - (Untitled) : art04.pho

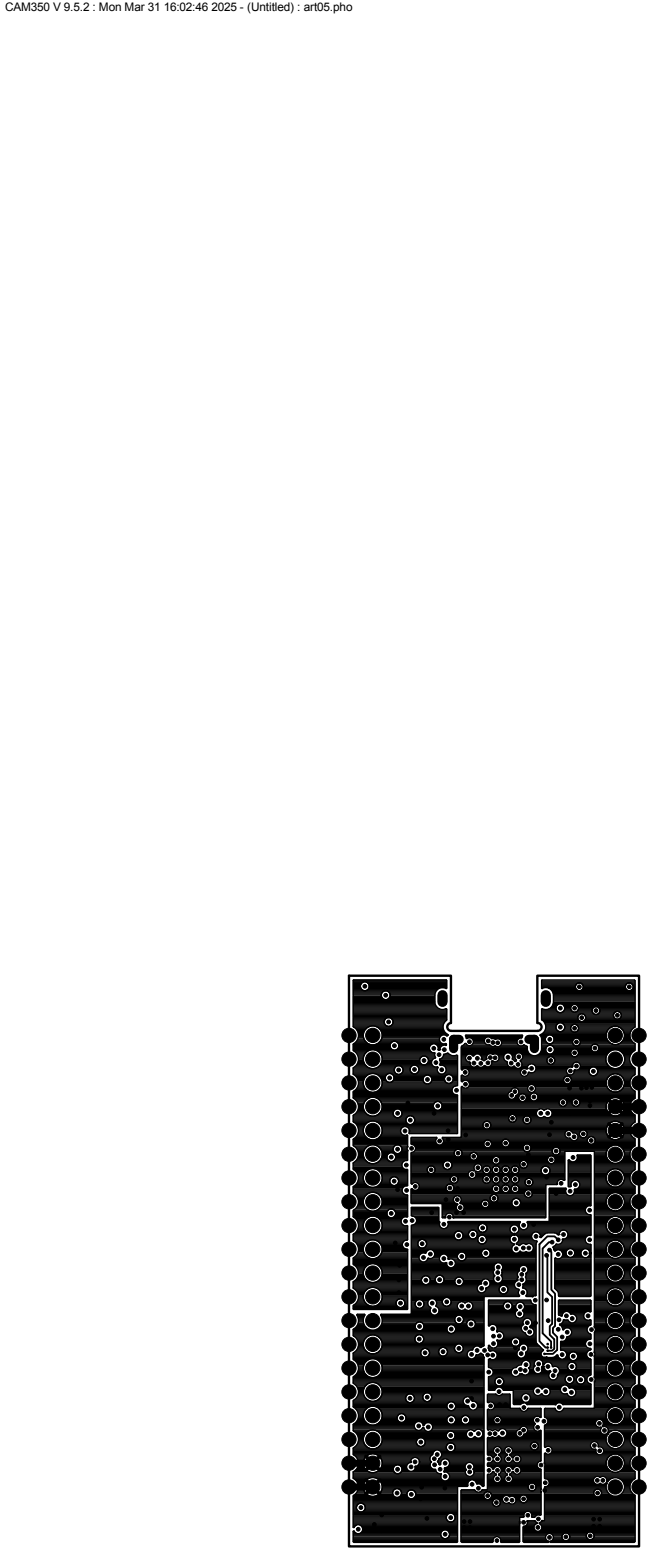
[picture p13: page 5]

CAM350 V 9.5.2 : Mon Mar 31 16:02:46 2025 - (Untitled) : art05.pho

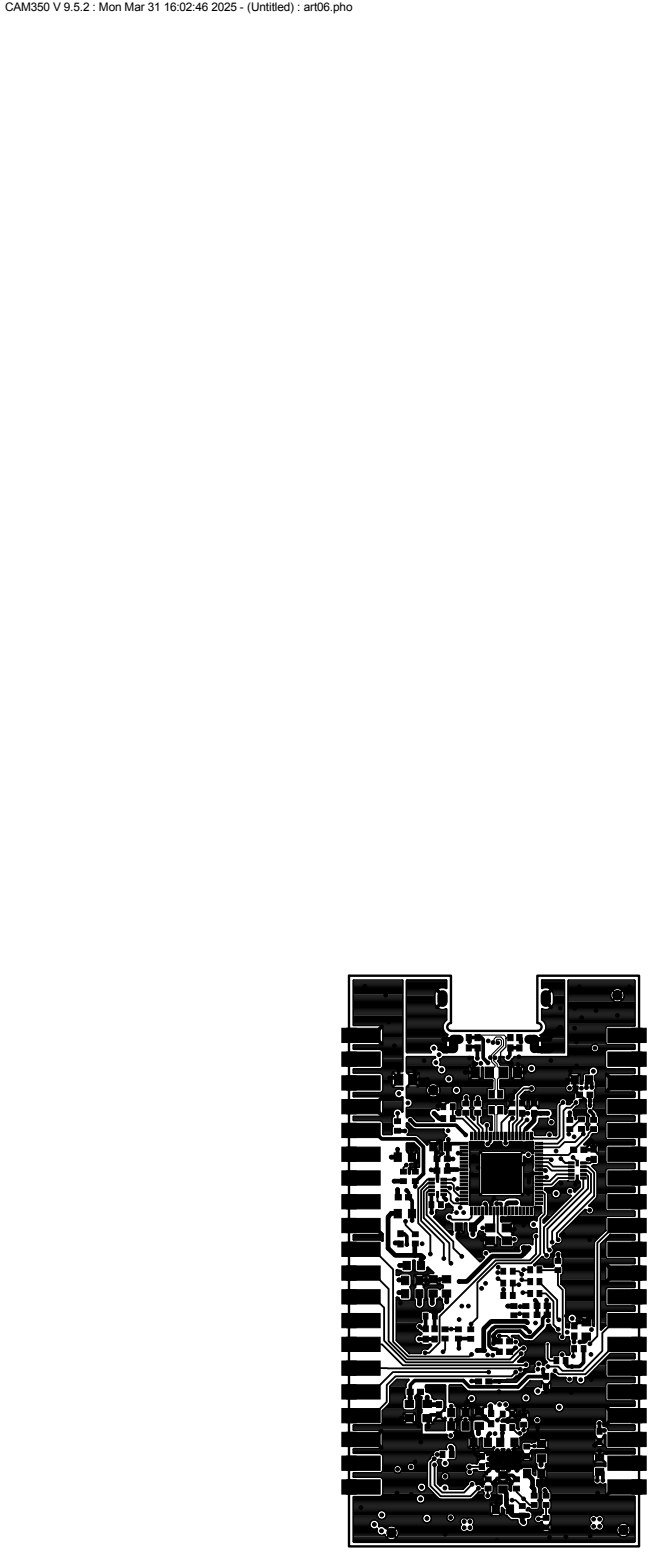
[picture p14: page 6]

CAM350 V 9.5.2 : Mon Mar 31 16:02:46 2025 - (Untitled) : art06.pho

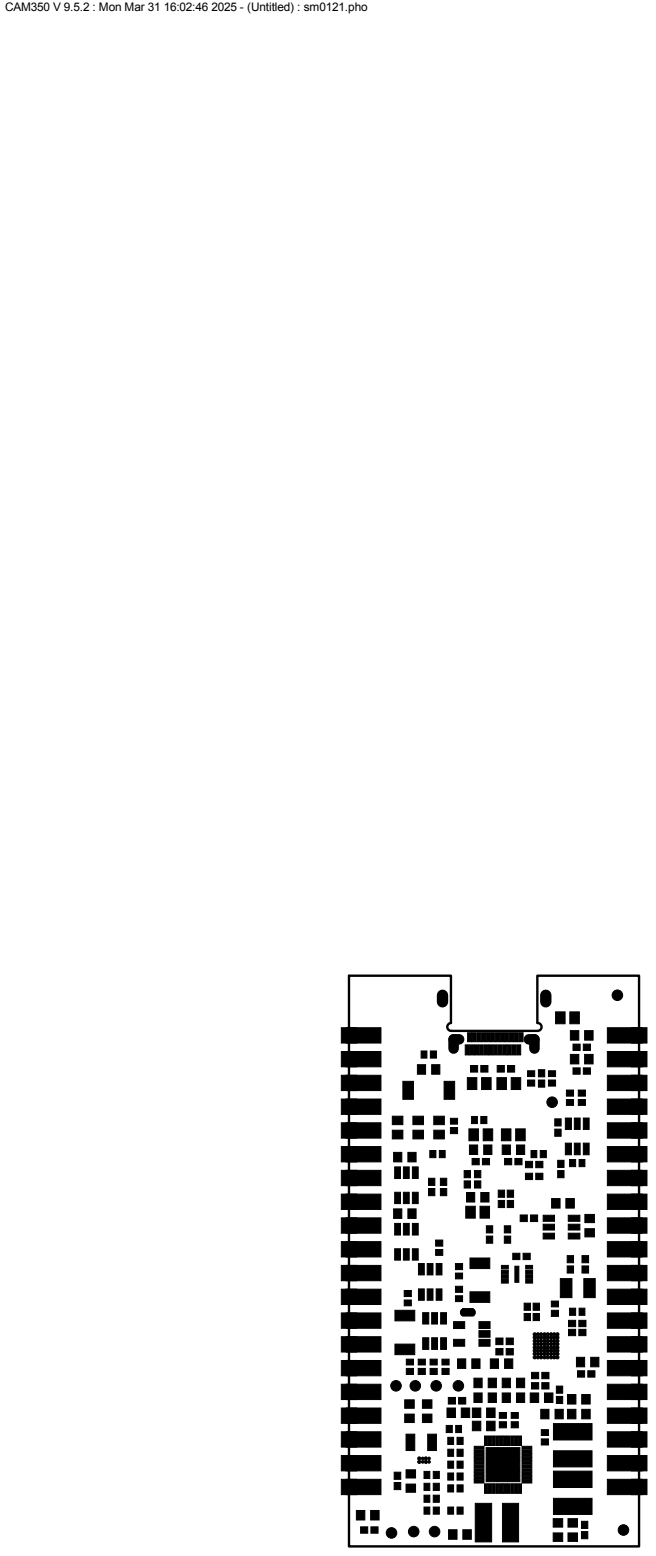
[picture p15: page 7]

CAM350 V 9.5.2 : Mon Mar 31 16:02:46 2025 - (Untitled) : sm0121.pho

CAM350 V 9.5.2 : Mon Mar 31 16:02:47 2025 - (Untitled) : sm0628.pho

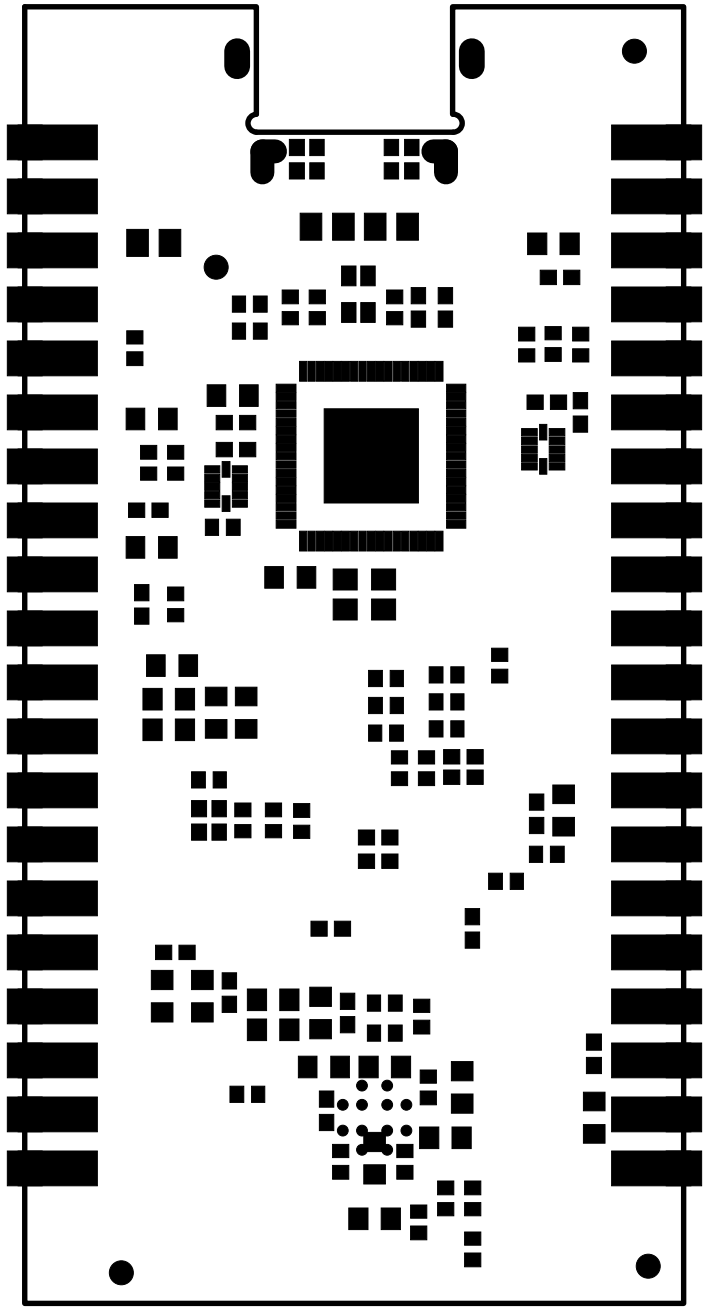
[picture p16: figure]
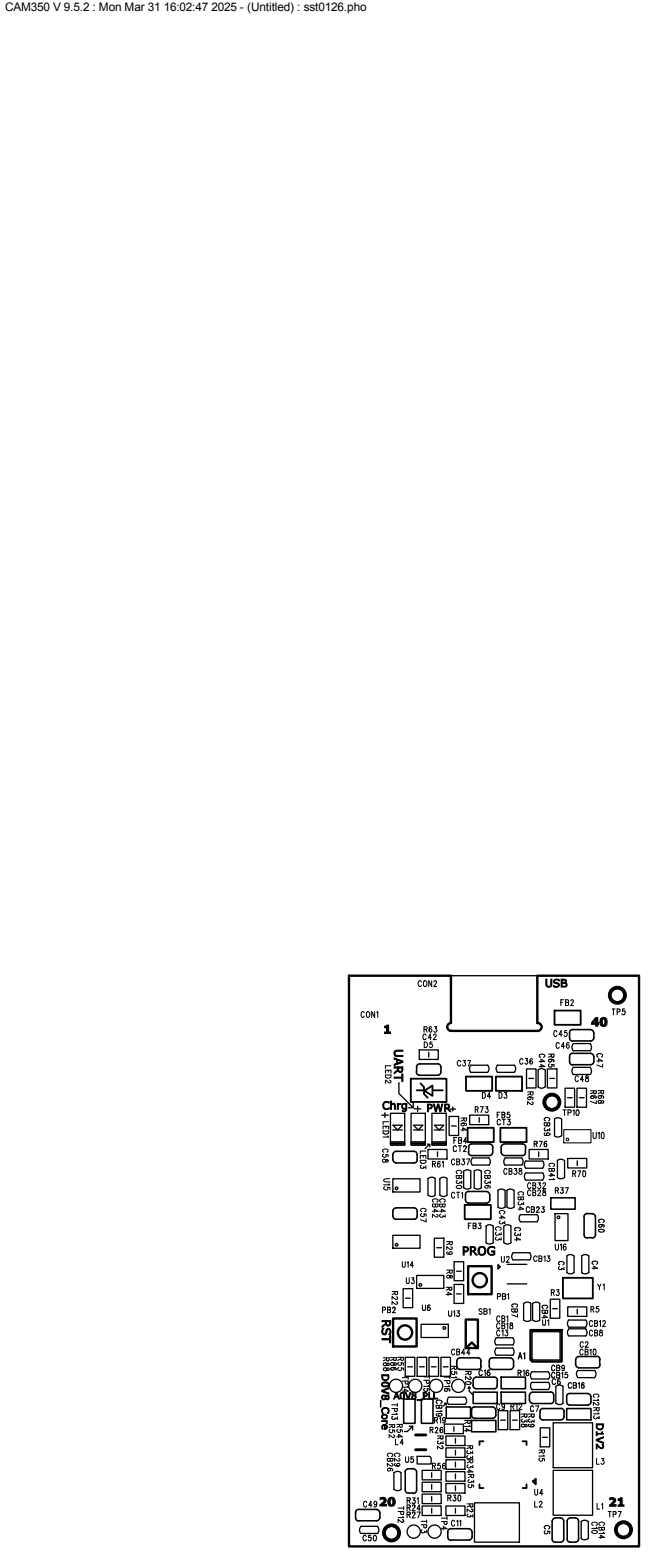
[picture p17: page 9]

CAM350 V 9.5.2 : Mon Mar 31 16:02:47 2025 - (Untitled) : sst0126.pho

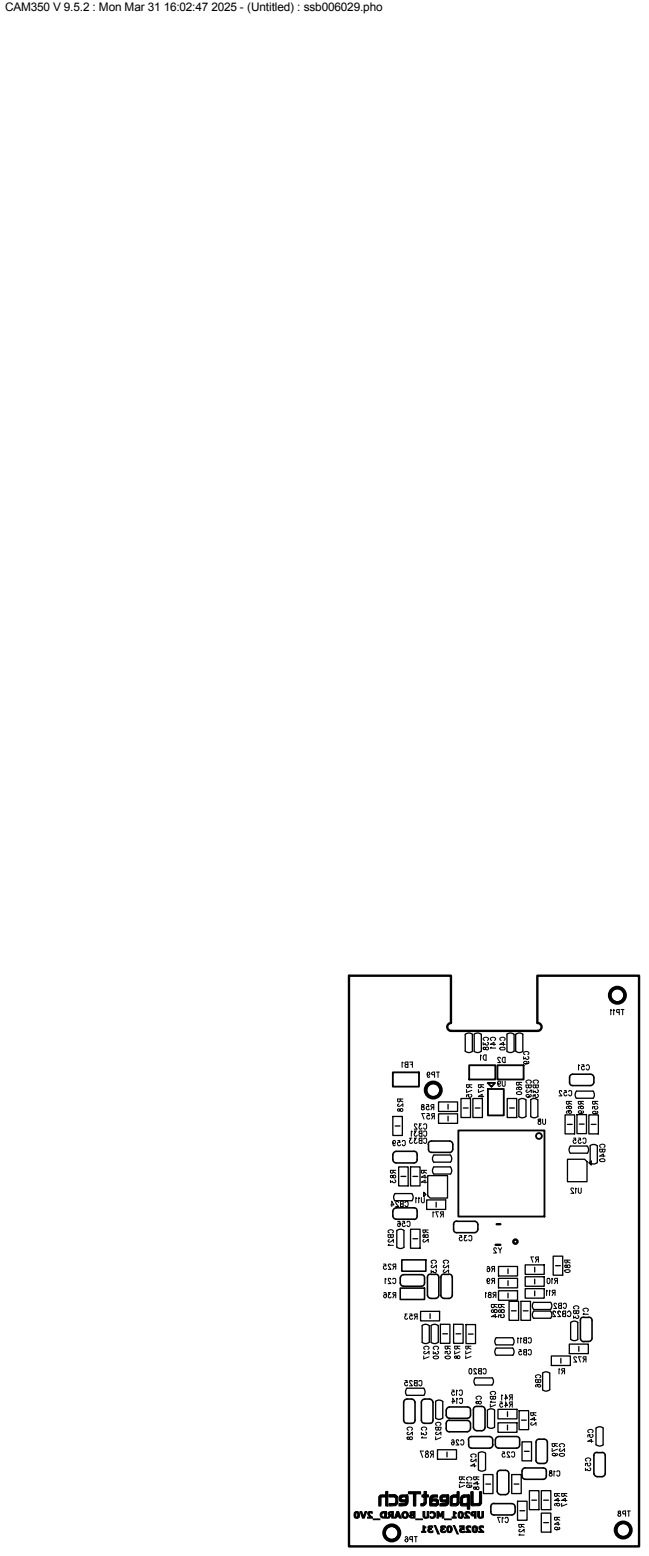
[picture p18: page 10]

CAM350 V 9.5.2 : Mon Mar 31 16:02:47 2025 - (Untitled) : ssb006029.pho

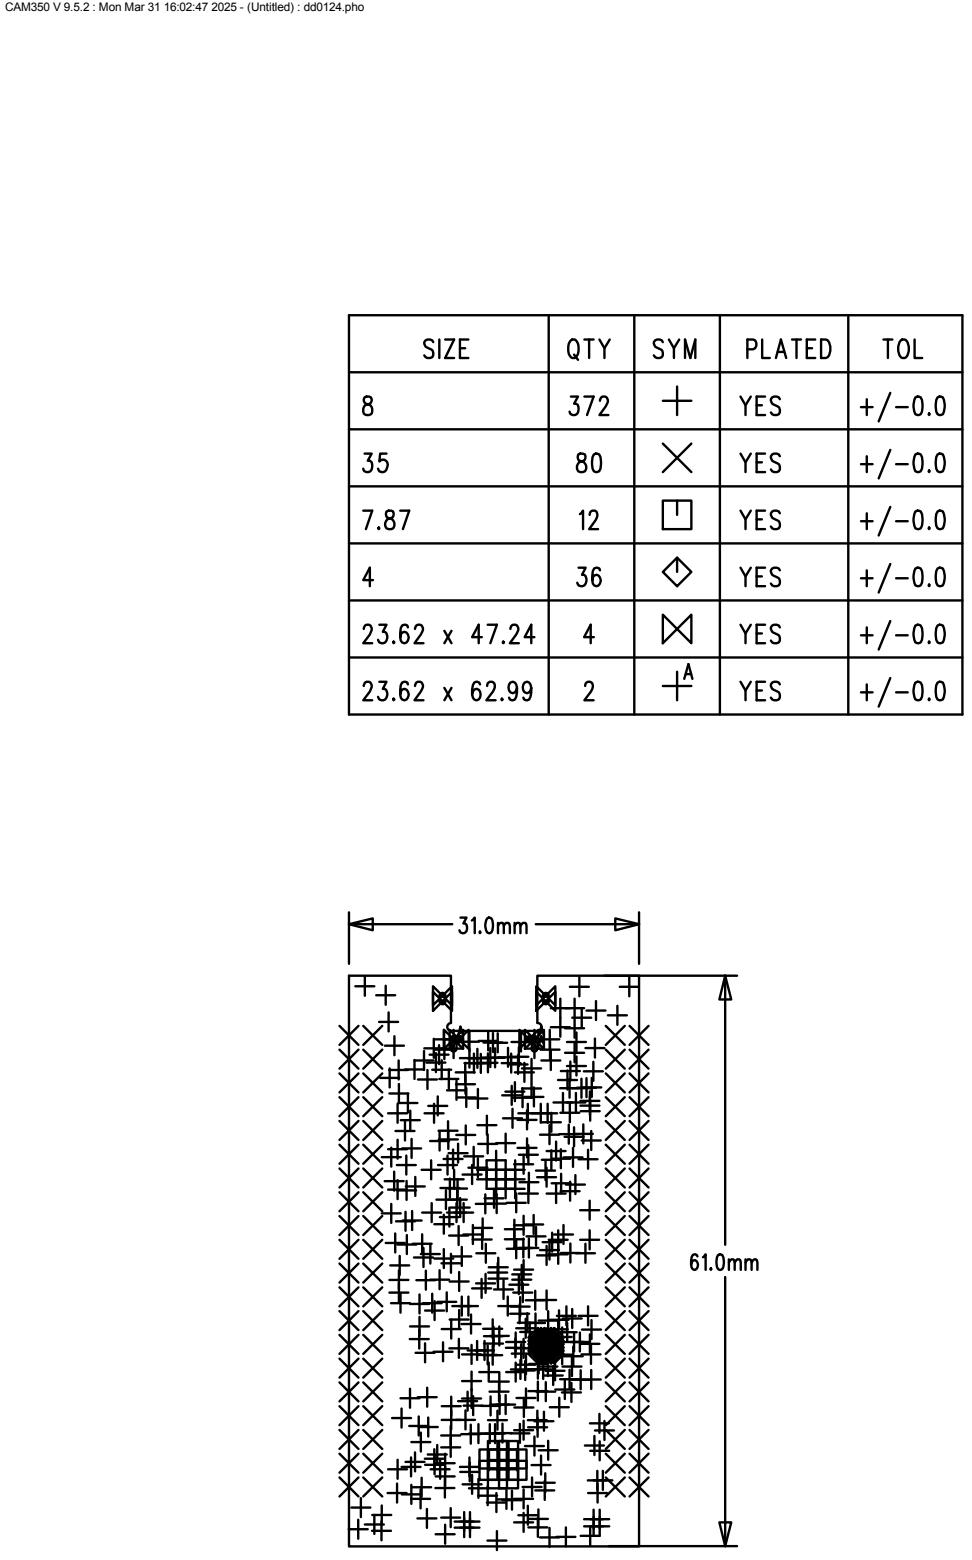
[picture p19: page 11]

CAM350 V 9.5.2 : Mon Mar 31 16:02:47 2025 - (Untitled) : dd0124.pho
